juandrodriguezf/robot-dibujante-2gdl/docs/informe-1/main.tex

\documentclass[10pt, letterpaper]{article}

\usepackage[utf8]{inputenc}
\usepackage[spanish]{babel}
\usepackage{amsmath}
\usepackage{amsfonts}
\usepackage{amssymb}
\usepackage{graphicx}
\usepackage{epstopdf}
\usepackage{url}
\usepackage{booktabs}
\usepackage{caption}
\usepackage{float}
\usepackage{tikz}
\usepackage{subcaption}
\usetikzlibrary{calc}
\usepackage{titlesec}
\usepackage[left=2.2cm, right=2.2cm, top=2.0cm, bottom=2.0cm]{geometry}

\titlespacing*{\section}{0pt}{8pt}{3pt}
\titlespacing*{\subsection}{0pt}{6pt}{2pt}
\setlength{\parskip}{0pt}
\captionsetup{font=small, skip=3pt}

% Estilos del diagrama de bloques
\tikzset{
  bloque/.style={draw, rectangle, align=center, font=\scriptsize,
                 minimum height=0.80cm, inner sep=3pt},
  suma/.style={draw, circle, minimum size=0.58cm, inner sep=0pt,
               font=\footnotesize},
  senal/.style={->, thick, >=latex},
  etiqueta/.style={font=\scriptsize, inner sep=1.5pt}
}

\begin{document}
\begin{center}
    {\LARGE Proyecto --- Parte 1: Especificaciones y modelado cinemático de robot de 2 GdL}
\end{center}
\textbf{Estudiantes: } 
\begin{enumerate}
    \item José Elkin Estrada Morales - \url{estradam_jose@javeriana.edu.co}
    \item Juan David Rodríguez Franco  - \url{juandrodriguezf@javeriana.edu.co}
    \item David Santiago Mojica Lugo -
    \url{david-mojical@javeriana.edu.co}
\end{enumerate}

\section{Métodos y Desarrollos}

\subsection{Introducción y objetivo del proyecto}

El presente proyecto tiene como objetivo diseñar y fabricar un robot manipulador de 2 grados de libertad (GdL) junto a la electrónica necesaria y la implementación de un sistema de control de movimiento. El propósito del robot será trazar una figura de manera autónoma sobre una superficie (como papel; véase la figura \ref{fig:draw_manipu} como referencia). La forma seleccionada por el equipo de trabajo será un triángulo con vértices redondeados (como se muestra en la figura \ref{fig:reul_triag}), conocido matemática y formalmente como ``triángulo de Reuleaux". 

\begin{figure}[H]
    \centering
    % Primera figura (a)
    \begin{subfigure}[b]{0.25\textwidth}
        \centering
         % Reemplaza por tu primera imagen
        \caption{\textit{Drawing manipulator} de Quanser \cite{barbosa_quanser}.}
        \label{fig:draw_manipu}
    \end{subfigure}
    \hspace{1cm}% Crea un espacio horizontal automático entre ambas figuras
    % Segunda figura (b)
    \begin{subfigure}[b]{0.25\textwidth}
        \centering
         % Reemplaza por tu segunda imagen
        \caption{Triaángulo de Reuleaux}
        \label{fig:reul_triag}
    \end{subfigure}
    
    % Caption y Label general de todo el conjunto
    \caption{\textbf{Izquierda:} Tipo de robot a diseñar. \textbf{Derecha: }Figura geométrica a realizar.}
    \label{fig:conjunto_figuras}
\end{figure}

La tarea concreta del robot será seguir una trayectoria continua con la geometría del triángulo. Para cumplir con dicho objetivo, el sistema debe, de forma iterativa y por cada punto de la trayectoria mencionada, establecer un modelo de cinemática directa de la posición actual y, justo después, resolver la cinemática inversa de la siguiente \cite{nakamura}, convirtiendo sus coordenadas en el espacio cartesiano en los valores requeridos de las variables articulares para que el efector final alcance dicho punto. La figura \ref{fig:block_diagram} muestra un diagrama de bloques que ilustra el proceso anteriormente mencionado. 

\begin{figure}[H]
    \centering
    
    \caption{Diagrama de bloques del funcionamiento del sistema}
    \label{fig:block_diagram}
\end{figure}

\subsection{Requerimientos}

Los requerimientos del robot dependen de aspectos como complejidad de las trayectorias, carga a soportar (en este caso un marcador), el volumen de trabajo y la dexteridad requerida. A continuación se presentan definiciones y más detalles sobre estos aspectos:

\textbf{Complejidad de la trayectoria:} La complejidad de una trayectoria puede cuantificarse a través de las siguientes métricas \cite{spong}: 

\begin{itemize}
    \item \textbf{Continuidad matemática ($C^k$): } En robótica, la continuidad matemática puede entenderse como la propiedad de que los movimientos de un robot no presenten cambios bruscos durante su ejecución \cite{spong}. Por ejemplo, una trayectoria puede clasificarse como $C^0$ si es continua (por ejemplo, que no sea necesario levantar el lápiz del papel para dibujar una figura), como $C^1$ es continua y así sucesivamente. 
    
    \item \textbf{Geometría del perfil y su curvatura: } La curvatura $\kappa$ es una medida de qué tan ``cerrado'' o pronunciado es un cambio de dirección en un punto específico de la trayectoria \cite{spong}. Matemáticamente, puede definirse como $ \kappa = |\dot{x}\ddot{y} - \dot{y}\ddot{x}|/(\dot{x}^2 + \dot{y})^{3/2}$, donde $x(t)$ y $y(t)$ son las coordenadas del marcador en el plano de dibujo a través del tiempo \cite{spong}. 

    \item \textbf{Frecuencia de muestreo y resolución de puntos: } Al seguir una trayectoria, el microcontrolador une cada uno de los puntos moviendo en línea recta el efector final. Si la frecuencia de muestreo es baja o no hay suficientes puntos en la trayectoria, las curvas no estarán bien logradas y la forma final será diferente a la esperada.
\end{itemize}
\textbf{Carga a soportar: } Los marcadores suelen tener una masa aproximadamente de 30 g, lo que implica un peso de 0.294 N. No es una carga significativa.

\textbf{Volumen de trabajo: } Es el conjunto de todos los puntos en el espacio tridimensional o bidimensional $(x, y)$ que el efector final del robot puede alcanzar \cite{spong}. Para un robot de 2 GdL plano, el volumen de trabajo es una región plana 2D con la forma de una semicorona circular con radio interior $R_{min} = L_1 - L_2$ y radio exterior $R_{max} = L_1 + L_2$. Como se verá en la sección \ref{sec:disenio}, se seleccionó $L_1 = 20 \text{ cm}$ y $L_2 = 10 \text{ cm}$. En ese orden de ideas, la región plana 2D del volumen de trabajo corresponde a una semicorona circular, mientras que la región 3D por la que el efector final puede desplazarse se muestra en la figura \ref{fig:3d_workspace}.

\begin{figure}[H]
    \centering
    
    \caption{Volumen de trabajo 3D del robot manipulador}
    \label{fig:3d_workspace}
\end{figure}

\textbf{Dexteridad: } Es la capacidad cinemática del manipulador para cambiar libremente la posición y orientación de de su efector final en un punto específico del espacio de trabajo \cite{spong}. Se cuantifica matemáticamente a partir de la matriz jacobiana $J(q)$ y métricas como el \textbf{Índice de Manipulabilidad de Yoshikawa}, definido como $w(q) = \sqrt{\det(J(q)J^T(q))}$ \cite{spong}. Para robots planares de 2 GdL, $w(q)$ puede escribirse como $w(q) = \vert L_1L_2\sin(\theta_2) \vert$ \cite{spong}, donde $\theta_2$ es el ángulo asociado a la segunda articulación. $w(q)$ mide qué tan ``lejos'' está el robot de una configuración singular. 

Por otra parte, otra métrica es el \textbf{Número de Condición del Jacobiano} \cite{spong}, expresado como
 
\begin{equation*}
   \kappa(J) = \Vert J \Vert \cdot \Vert J^{-1} \Vert = \frac{\sigma_{max}}{\sigma_{min}},
\end{equation*}

donde $\sigma_{max}$ y $\sigma_{min}$ son, respectivamente, los valores singulares máximos y mínimos de $J$. 

Teniendo en cuenta todos los aspectos mencionados anteriormente, los requerimientos establecidos para el sistema se muestran en la tabla \ref{tab:requerimientos}.

\begin{table}[H]
    \centering
    \caption{Requerimientos del sistema}
    \label{tab:requerimientos}
    \begin{tabular}{|p{4.5cm}|p{4.5cm}|p{6cm}|}
    \hline
    \textbf{Especificación} & \textbf{Métrica} & \textbf{Breve justificación} \\ \hline
    Continuidad matemática & $C^1$ (posición y velocidad continuas) & Garantiza transiciones suaves de movimiento \\ \hline
    Velocidad cartesiana en los vértices & $v \to 0$ (tendiendo a cero) & Prevenir discontinuides en la función de curvatura $\kappa$. \\ \hline
    Tiempo de muestreo & $\Delta t \le 0.01$ s ($f_s \ge 100$ Hz) & Garantizar un seguimiento fino y evitar la poligonalización del trazado curvo. \\ \hline
    Orden polinómico de interpolación & Polinomios de orden 3 (splines cúbicos) & Asegura la continuidad $C^1$, proporcionando perfiles de velocidad continuos. \\ \hline
    Capacidad de carga útil (Payload) & $\ge 0.294$ N ($30$ g) & Garantizar el soporte del marcador sin afectar la dinámica. \\ \hline
    Alcance radial de la zona de trabajo & Semicorona circular con $R_{min} = 10$ cm y $R_{max} = 30$ cm & Contener al triángulo de Reuleaux, alejándolo de los límites físicos y configuraciones singulares del brazo. \\ \hline
    Límite del Índice de Yoshikawa & Evitar $\theta_2 = 0^\circ$ y $\theta_2 = 180^\circ$ & Evitar la pérdida de grados de libertad por efecto de singularidades. \\ \hline
    Número de Condición del Jacobiano & $\kappa(J)$ cercano a $1$ ($\kappa(J) \ll \infty$) & Evitar configuraciones singulares (de forma parecida al índice de Yoshikawa) \\ \hline
    \end{tabular}
\end{table}
 
\subsection{Componentes}

Los componentes necesarios para el robot se muestran en la tabla \ref{tab:compos}.

\begin{table}[H]
    \centering
    \caption{Componentes del sistema con características, función y costos asociados}
    \label{tab:compos}
    \begin{minipage}{15.2cm} % Ajustado a la suma de las columnas: 3.2 + 4.5 + 4.5 + 2.2 = 14.4cm + márgenes
        \centering
        \begin{tabular}{|p{3.2cm}|p{4.5cm}|p{4.5cm}|p{2.2cm}|}
        \hline
        \textbf{Componente} & \textbf{Características} & \textbf{Función} & \textbf{Costo (COP)} \\ \hline
        Servomotores Futaba S3003 (x2) & \textbf{Torque:} 4.1 kg-cm \newline \textbf{Voltaje:} 6 V \newline \textbf{Rotación:} 180$^\circ$ \newline \textbf{Velocidad*:} 0.19 s / 60$^\circ$ & Actuadores & \$37 800 \\ \hline
        Microcontrolador ESP32-S3 & Procesador Xtensa® LX7 de doble núcleo \newline 16 MB de memoria Flash \newline 8 MB de memoria PSRAM & Solución de problemas cinemáticos, control de movimiento e interpolación de trayectorias. & Posesión del equipo \\ \hline
        Lámina de balso & Tamaño & Material para base y eslabones. & \$20 000 \\ \hline
        Marcador Sharpie & Color negro & Dibujo & \$2 500 \\ \hline
        \end{tabular}
        
        \vspace{1.5mm} % Controla la cercanía del texto con la tabla
        \raggedright \footnotesize $^*$ Como puede intuirse, las velocidades máximas articulares del robot coinciden con las velocidad de los servomotores.
    \end{minipage}
\end{table}
\section{Dise\~no y par\'ametros DH}
\label{sec:disenio}
El robot tiene una base fija y dos eslabones de balso, cada uno movido por un servo; el esfero va en el extremo del eslab\'on~2. Los dos ejes son verticales y paralelos, por lo que la punta se mueve en el plano del papel.
 
\textbf{Marcos y par\'ametros DH.} Se us\'o la convenci\'on DH est\'andar (Fig.~\ref{fig:marcos}). El marco mundo $\{W\}$ est\'a sobre el papel y $\{0\}$ queda sobre el eje del servo~1 a $h_0=48{,}5$~mm de altura: ${}^{W}\mathbf{T}_{0}=\mathrm{trasl}(0,0,h_0)$. Los ejes $z_0$ y $z_1$ son verticales, as\'i que $\alpha_1=\alpha_2=0$ y las articulaciones son rotacionales ($\sigma_i=0$). Los dem\'as par\'ametros salen de la geometr\'ia (Tabla~\ref{tab:dh}):
$a_1=200$~mm y $a_2=100$~mm son las distancias entre ejes; $d_1=20$~mm es la altura de $\{0\}$ a $\{1\}$ (plano del eslab\'on~2), por lo que $\{1\}$ queda a $h_0+d_1=68{,}5$~mm del papel; y $d_2=-68{,}5$~mm baja de $\{1\}$ hasta $\{2\}$, ubicado en la punta del esfero sobre el papel ($z_W=0$).
 
\begin{table}[!t]
\caption{Par\'ametros DH (est\'andar), $q_i\in[-90^\circ,90^\circ]$}
\label{tab:dh}
\centering
\begin{tabular}{c c c c c c}
\toprule
$i$ & $\theta_i$ & $d_i$ [m] & $a_i$ [m] & $\alpha_i$ [rad] & $\sigma_i$ \\
\midrule
1 & $q_1$ & $+0{,}0200$ & $0{,}2000$ & 0 & 0 \\
2 & $q_2$ & $-0{,}0685$ & $0{,}1000$ & 0 & 0 \\
\bottomrule
\end{tabular}
\end{table}
 
\begin{figure}[!t]
\centering
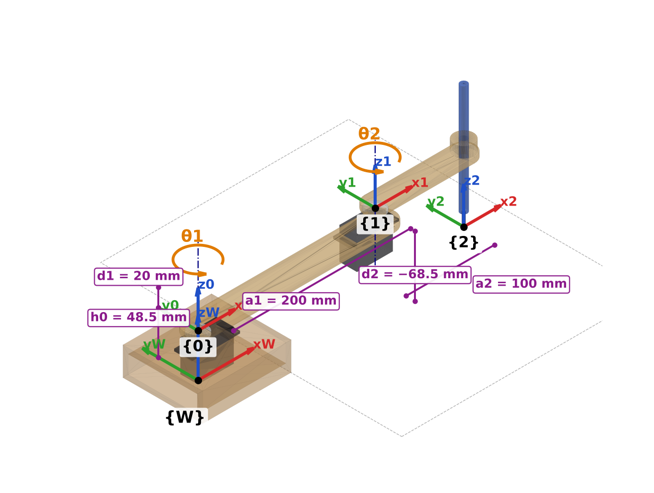
[picture p2: docs/informe-1/figuras/esquematico_1.png]
\hfill
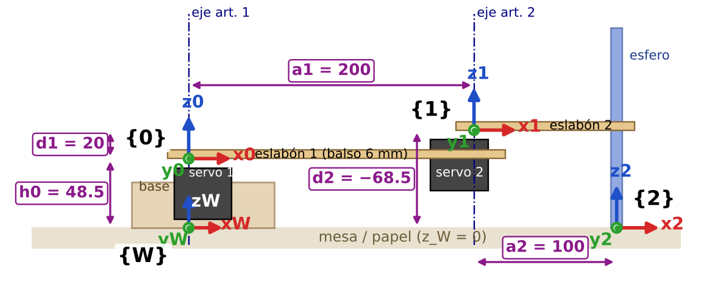
[picture p3: docs/informe-1/figuras/esquematico_2.png]

\caption{Marcos $\{W\}$, $\{0\}$, $\{1\}$, $\{2\}$ y dimensiones del robot.}
\label{fig:marcos}
\end{figure}
 
Con estos valores, las matrices de transformaci\'on son
\begin{equation}
{}^{0}\mathbf{A}_{1}\!=\!\begin{bmatrix}c_1&-s_1&0&0{,}2c_1\\ s_1&c_1&0&0{,}2s_1\\ 0&0&1&0{,}02\\ 0&0&0&1\end{bmatrix}\!,\;
{}^{1}\mathbf{A}_{2}\!=\!\begin{bmatrix}c_2&-s_2&0&0{,}1c_2\\ s_2&c_2&0&0{,}1s_2\\ 0&0&1&-0{,}0685\\ 0&0&0&1\end{bmatrix}
\end{equation}
y ${}^{W}\mathbf{T}_{2}={}^{W}\mathbf{T}_{0}\,{}^{0}\mathbf{A}_{1}\,{}^{1}\mathbf{A}_{2}$. La altura de la punta es $0{,}0485+0{,}02-0{,}0685=0$ y su posici\'on en el plano es $x=0{,}2\cos q_1+0{,}1\cos(q_1+q_2)$, $y=0{,}2\sin q_1+0{,}1\sin(q_1+q_2)$. En \textit{home} la punta queda en $(0{,}3;\,0;\,0)$~m.
 
\textbf{Masas e inercias.} Se obtuvieron en SolidWorks (propiedades de masa) agrupando las piezas por cuerpo r\'igido: la base lleva el servo~1 y el eslab\'on~1 lleva el servo~2, que viaja con \'el; el eslab\'on~2 incluye el balso, el \textit{horn} y el esfero. Los valores est\'an referidos al centro de masa y expresados en los ejes del marco $\{i\}$ de cada eslab\'on. Las masas son $m_1=43{,}90$~g y $m_2=10{,}34$~g (54,24~g en movimiento), con centros de masa
$\mathbf{r}_1=[-0{,}02689;\,0;\,-0{,}02310]$~m y $\mathbf{r}_2=[-0{,}02227;\,0;\,0{,}07451]$~m, y tensores de inercia (kg\,m$^2$)
{\footnotesize
\begin{equation}
\mathbf{I}_1\!=\!\begin{bmatrix}6{,}0512\mathrm{e}{-6}&0&3{,}7272\mathrm{e}{-6}\\ 0&1{,}0736\mathrm{e}{-4}&0\\ 3{,}7272\mathrm{e}{-6}&0&1{,}0469\mathrm{e}{-4}\end{bmatrix}
\end{equation}
\begin{equation}
\mathbf{I}_2\!=\!\begin{bmatrix}8{,}5081\mathrm{e}{-6}&0&-1{,}0612\mathrm{e}{-6}\\ 0&2{,}2523\mathrm{e}{-5}&0\\ -1{,}0612\mathrm{e}{-6}&0&1{,}4440\mathrm{e}{-5}\end{bmatrix}
\end{equation}
}
Como los ejes son verticales, en el plano solo intervienen $I_{zz}$ y la posici\'on de los centros de masa.
 
\textbf{Validaci\'on.} El modelo se implement\'o con \texttt{SerialLink} cargando la Tabla~\ref{tab:dh} y los valores anteriores, y se verific\'o que: (i) \texttt{fkine([0 0])} da $(0{,}3;0;0)$~m, igual al CAD; (ii) con 2000 poses aleatorias, \texttt{fkine} coincide con las matrices DH a mano y con la geometr\'ia anal\'itica (error $<10^{-12}$); (iii) la matriz de inercia $\mathbf{M}(\mathbf{q})$ de la toolbox coincide con un c\'alculo independiente por Steiner (error $<10^{-10}$); (iv) la masa en movimiento coincide con SolidWorks; y (v) \texttt{gravload}$\,\approx 0$, pues la estructura soporta el peso y los servos solo vencen la inercia.
 
%-----------------------------------------------------------------------
\section{Modelo CAD}
El modelo se realiz\'o en SolidWorks como ensamblaje (\texttt{Plotter\_2GdL.SLDASM}) con base, dos eslabones de balso de 6~mm, dos servos S3003, \textit{horn} y esfero (Fig.~\ref{fig:cad}). De \'el se extrajeron las longitudes, los desplazamientos $d_i$, las masas y las inercias usadas arriba.
 
\begin{figure}[!t]
\centering
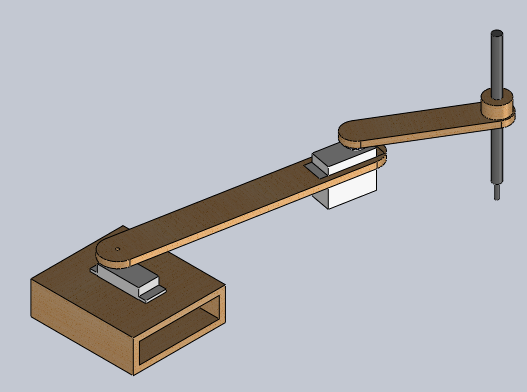
[picture p4: docs/informe-1/figuras/cad_isometrica.png]
\hfill
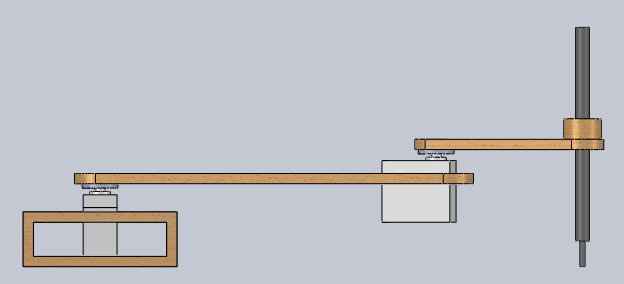
[picture p5: docs/informe-1/figuras/cad_lateral.png]

\caption{Modelo CAD del plotter: vista isom\'etrica (izq.) y lateral (der.).}
\label{fig:cad}
\end{figure}

\section{Resultados}

\subsection{Cinemática directa}

La cinemática directa se implementó en \texttt{forward\_kinematics(DH,q)} sobre
los marcos de la figura~\ref{fig:marcos} y se validó en $q=[60^\circ,-50^\circ]$:
coincide con la solución analítica y con \texttt{SerialLink.fkine} del Robotics
Toolbox con un error máximo de $2{,}8\times10^{-17}$~m. El volumen de trabajo es
una corona con $R_{min}=L_1-L_2=0{,}1$~m y $R_{max}=L_1+L_2=0{,}3$~m que
contiene al triángulo de Reuleaux.

\subsection{Cinemática inversa}

Para el brazo plano $\dot{\mathbf p}_e=\mathbf J_v(q)\,\dot{\mathbf q}$, con
$\mathbf J_v$ el Jacobiano lineal y $\det\mathbf J_v=L_1L_2\sin q_2$ (singular
en $q_2=0^\circ$ o $180^\circ$). La inversa itera
$\mathbf q_{k+1}=\mathbf q_k+\mathbf J_v^{+}\bigl(\mathbf p_{obj}-\mathbf p_e(\mathbf q_k)\bigr)$
(pseudoinversa de Moore--Penrose, amortiguada cerca de singularidades). El
Jacobiano se verificó en $q=[30^\circ,-70^\circ]$, donde
$\det\mathbf J_v=-0{,}018794=L_1L_2\sin q_2$. Para
$\mathbf p_{obj}=[0{,}08;\,0{,}20]$~m la forma cerrada da las ramas
A $q=[40{,}7^\circ,\,95{,}2^\circ]$ y B $q=[95{,}7^\circ,\,-95{,}2^\circ]$;
\texttt{ikine} recupera \emph{ambas} según la semilla con error de posición
$<3\times10^{-11}$~m (figura~\ref{fig:ik_ramas}). El índice de manipulabilidad
$w=L_1L_2|\sin q_2|$ es máximo en $r=\sqrt{L_1^2+L_2^2}=0{,}2236$~m y tiende a
cero en los límites $r=0{,}1$ y $0{,}3$~m (figura~\ref{fig:ik_sing}).

\begin{figure}[!t]
\centering
\begin{subfigure}[b]{0.38\columnwidth}
    \centering
    
    \caption{Ramas A y B (codo arriba/abajo) al mismo punto.}
    \label{fig:ik_ramas}
\end{subfigure}\hfill
\begin{subfigure}[b]{0.38\columnwidth}
    \centering
    
    \caption{Manipulabilidad $|\det\mathbf J_v|$ vs.\ radio $r$.}
    \label{fig:ik_sing}
\end{subfigure}
\caption{Resultados de la cinemática inversa.}
\end{figure}

\subsection{Planeación de trayectorias}

Se trazó el triángulo de Reuleaux ($w=0{,}10$~m, centro $(0;\,0{,}20)$~m),
discretizado en $50$ puntos e interpolado con splines cúbicos; un reescalado
temporal suave anula la velocidad cartesiana en los tres vértices. Con muestreo
$\Delta t=0{,}01$~s ($2001$ puntos) la inversa convergió en todos los puntos con
error $<1\times10^{-10}$~m. Las figuras~\ref{fig:tray_cart} y
\ref{fig:tray_art} muestran las trayectorias cartesiana y articular; las
velocidades máximas ($0{,}15$ y $0{,}21$~rad/s) quedan por debajo del límite de
los servos S3003 ($5{,}5$~rad/s). La figura~\ref{fig:tray_cad} presenta la
simulación con el modelo CAD real.

\begin{figure}[!t]
\centering
\begin{subfigure}[b]{0.38\columnwidth}
    \centering
    
    \caption{Trayectoria cartesiana $x(t)$, $y(t)$ y trazado.}
    \label{fig:tray_cart}
\end{subfigure}\hfill
\begin{subfigure}[b]{0.38\columnwidth}
    \centering
    
    \caption{Trayectorias articulares $q(t)$, $\dot q(t)$, $\ddot q(t)$.}
    \label{fig:tray_art}
\end{subfigure}
\caption{Resultados de la planeación de trayectorias.}
\end{figure}

\begin{figure}[!t]
\centering

\caption{Simulación con el modelo CAD real ejecutando el trazado.}
\label{fig:tray_cad}
\end{figure}

\section{Conclusiones}

El modelo cinemático quedó validado: la cinemática directa coincide con la
analítica y con el Robotics Toolbox (error $\sim10^{-17}$~m), y la inversa por el
Jacobiano recupera ambas configuraciones con error $<10^{-10}$~m, lejos de las
singularidades ($q_2 = 0^\circ,\,180^\circ$).

La planeación genera perfiles articulares $C^1$ con velocidad nula en los
vértices y convergencia en los $2001$ puntos; las velocidades máximas
($0{,}15$ y $0{,}21$~rad/s) quedan bajo el límite del servo ($5{,}5$~rad/s).

\bibliographystyle{ieeetr} % Define el estilo de formato (puedes cambiarlo por plain, unsrt, etc.)
\bibliography{referencias} % Llama a tu archivo .bib (no incluyas la extensión .bib aquí)

\end{document}
