juandrodriguezf/robot-dibujante-2gdl/docs/informe-2/main.pdf

# Proyecto — Parte 2: Dinámica inversa, modelado y control de un drawing manipulator de 2 GdL

Estudiantes:

1. José Elkin Estrada Morales - estradam_jose@javeriana.edu.co
2. Juan David Rodríguez Franco - juandrodriguezf@javeriana.edu.co
3. David Santiago Mojica Lugo - david-mojical@javeriana.edu.co

## 1. Métodos y Desarrollos

### 1.1. Modelo de dinámica inversa

Tras haber resuelto los modelos de cinemática directa, inversa y las trayectorias, la descripción geométrica del movimiento del manipulador queda completamente definida. En la presente entrega se aborda el modelo de dinámica inversa. Este proceso consiste en determinar los torques y fuerzas que deben ejercer los actuadores para que el efector final alcance y siga las posiciones, velocidades y aceleraciones deseadas a lo largo del recorrido, para posteriormente seleccionar los motores adecuados para las cargas del sistema. El flujo de variables que describen este procedimiento se ilustran en el diagrama de bloques de la figura 1.

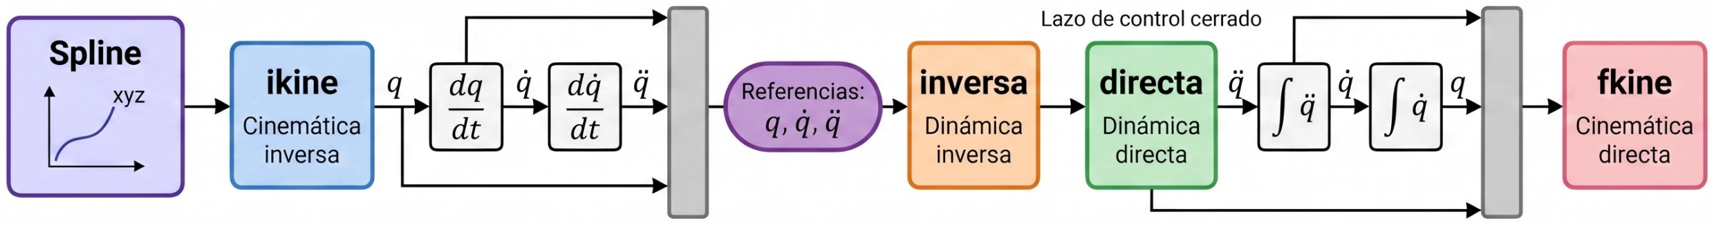
[picture p6: figure]

Figura 1: Diagrama de bloques de algoritmo completo para control de un manipulador

Así, para resolver el modelo dinámico inverso del manipulador se implementó el algoritmo recursivo de Newton-Euler (RNE, por sus siglas en inglés). Este método es la línea base del estado del arte debido a su alta eficiencia computacional y a su escalabilidad a robots con más GdL. El algoritmo determina iterativamente las velocidades, aceleraciones y fuerzas propagadas en cada eslabón a partir de tres ecuaciones principales para cada variable, las cuales se muestran en (1)

Vi = RT P Vi−1 + Hq˙i
V˙

i = RT PV˙

i−1 + W˜

i−1RT P Vi−1 + Hiqï + W˜
iHq˙i
Fi = P

T RFi+1 + IiV˙

i + [IiW˜

iSi,cm + W˜
iIi

] · Vi

. | (1)

Donde, para cada eslabón i, Vi y V˙ i representan los vectores de velocidad y aceleración espacial en R

6
(que
agrupan las componentes angulares y lineales), mientras que ˙qi y ¨qi corresponden a la velocidad y aceleración escalar de la articulación. Por su parte, R y P denotan los operadores espaciales de rotación y traslación entre sistemas de referencia consecutivos, y H (o Hi) es el vector de proyección espacial que refleja el movimiento sobre el eje de actuación correspondiente. Asimismo, W˜
i ∈ R

6×6
es una matriz diagonal por bloques conformada por las matrices antisimétricas de las velocidades angulares del eslabón. Finalmente, Fi representa el vector de fuerza espacial (torsor de fuerzas y momentos) ejercido en la articulación, Ii corresponde al operador espacial de inercia del cuerpo rígido y Si,cm es el operador espacial de traslación desde el marco de referencia de la articulación hasta el centro de masa del eslabón.
En este orden de ideas, el procedimiento recursivo finaliza extrayendo el torque o fuerza escalar (τi) requerido por cada articulación para ejecutar el movimiento deseado. Dicha magnitud se obtiene proyectando el vector de fuerza espacial Fi ∈ R

6×1
sobre el vector transpuesto del subespacio de movimiento articular HT

i ∈ R 1×6
, tal
como se expresa en (2).

τi = HT
i Fi | (2)

Esta operación aísla la componente de esfuerzo efectiva sobre el eje de actuación —correspondiente al momento τz en articulaciones rotacionales o a la fuerza fz en prismáticas—, proporcionando los valores críticos de carga necesarios para dimensionar y validar la selección de los actuadores del manipulador.

### 1.2. Modelado de motores y sensores

El S3003 es un servo integrado: incluye motor, reductora, potenciómetro y controlador analógico. El lazo de posición ya viene cerrado y el servo solo recibe PWM; por eso, para simulación se adopta un motor DC equivalente de primer orden referido al eje de salida, calibrado con el datasheet [1]. En la parte experimental se usa el S3003 tal como se compró.
El modelo se implementó en MATLAB/Simulink con una instancia por grado de libertad: Joint1 y Joint2 en motor 2gdl.slx. Cada instancia incluye la planta DC y los sensores de posición, corriente y velocidad necesarios para el control de bajo nivel de su articulación. La figura 2 presenta el diagrama de una instancia (Joint1); el modelo completo contiene dos instancias idénticas, Joint1 y Joint2, una por grado de libertad. Los parámetros se ajustaron con el datasheet del S3003. No se usó Simscape Electrical porque no está licenciado; se emplearon

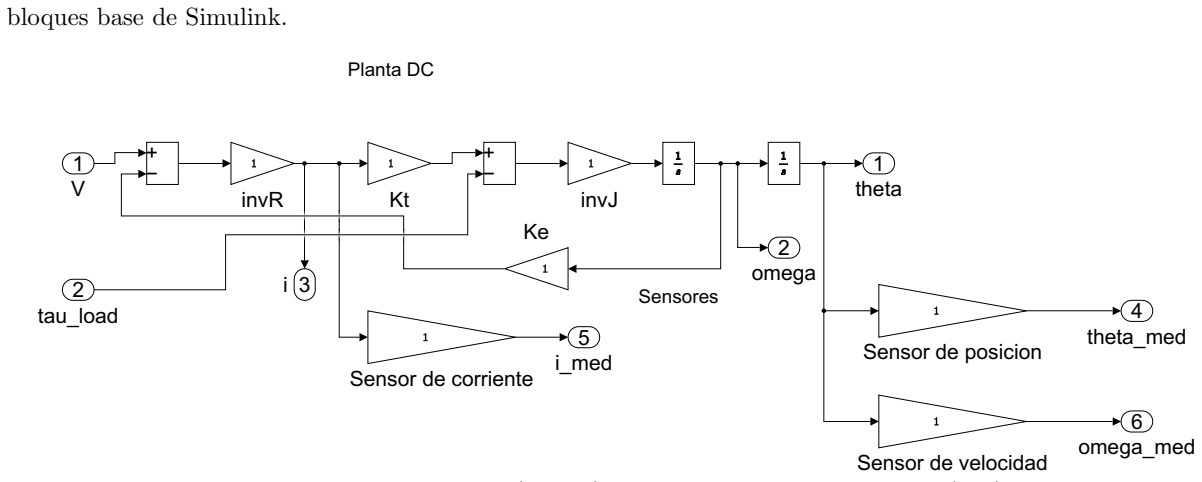
[picture p7: figure]
bloques base de Simulink.; Sensores; Planta DC; 2 tau_load; invR; invJ; 1 theta; 2 omega; Sensor de posicion; 4 theta_med; Sensor de corriente; 5 i_med; Sensor de velocidad; 6 omega_med

Figura 2: Diagrama de bloques de una instancia (Joint1) del modelo de motor y sensores (P10). El modelo completo contiene dos instancias idénticas, una por GdL.

El modelo resuelve las ecuaciones

i =

V − Keω
R
, | (3)
Jω˙ = Kti − τload, | (4)
˙θ = ω, | (5)

donde V es la tensión de entrada, i la corriente, ω la velocidad y θ la posición del eje de salida. La corriente se obtiene con (3), la dinámica mecánica con (4) y la posición integrando (5). La inductancia L y el amortiguamiento B se desprecian para obtener el modelo de primer orden; J se estima a partir de un valor típico de servo pequeño. Los parámetros se resumen en la tabla 1.

Tabla 1: Parámetros del motor equivalente.

Parámetro | Notación | Valor [Unidad]
Constante de fuerza y par | Ke = Kt | 1,0886 V·s/rad = N·m/A
Resistencia | R | 16,245 Ω
Inercia | J | 3 × 10⁻⁴ kg·m²
Inductancia | L | 0 H
Amortiguamiento | B | 0 N·m·s/rad
Tensión máxima | Vmax | 6 V
Velocidad sin carga | ωnl | 5,5116 rad/s
Par de bloqueo | τstall | 0,4021 N·m
Corriente de bloqueo | istall | 0,3693 A
Constante de velocidad | K = 1/Ke | 0,9186 rad/s/V
Constante de tiempo | τm = JR/(KtKe) | 4,11 ms

Los valores de Ke, R, Vmax, ωnl y τstall provienen del datasheet; J es estimada y L, B se desprecian.

Los sensores se modelan de forma genérica, porque el S3003 no expone el potenciómetro ni la corriente del motor. La tabla 2 resume sus características.

Tabla 2: Sensores modelados para el control de bajo nivel de cada GdL.

Sensor | Modelo | Parámetros
Posición | Cuantización + ruido + saturación | ±90◦
; 0,5

◦

; 0,05◦
Corriente | Filtro + ruido + saturación | ±1 A; 2 mA; 1000 Hz
Velocidad | Derivada filtrada | 20 Hz

El periodo de muestreo es Ts = 0,01 s. La carga mecánica se incluye como series de tiempo tau1 y tau2, calculadas con carga mecanica.m; el par máximo es 0,177 mN·m y su efecto en la velocidad es 0,0013 rad/s (0,024 %).

### 1.3. Control de bajo nivel

El S3003 ya incorpora un lazo interno de posición. Para simular el control de bajo nivel se replicó un controlador proporcional con prealimentación de velocidad en cada instancia (Joint1 y Joint2). La ley implementada en (6), evaluada con Ts = 10 ms y la posición medida, es

Vk = sat±6

h
Kp

θref,k − θmed,k

+ Kf f ˙θref,ki
, | (6)

con Kp = 40/K = 43,5 V/rad y Kf f = Ke = 1,0886 V·s/rad. El término Kf f ˙θref entrega la tensión asociada a la fuerza contraelectromotriz, de modo que el término proporcional solo corrige el error de posición. Si se desprecia la carga y la saturación no actúa, al sustituir la ley de control en la planta de P10 el error e = θref − θ obedece a (7):

Jë+

KtKe
R

e˙ +

KtKp
R

e = 0, ωn =

r
KtKp
JR

, ζ =

KtKe/R
2Jωn
. | (7)

Con J = 3 × 10⁻⁴ kg·m²
, R = 16,245 Ω, Kt = Ke = 1,0886 y Kp = 43,5 V/rad se obtiene ωn = 98,6 rad/s y ζ = 1,23; el lazo es estable y sobreamortiguado, por lo que el escalón no presenta oscilación apreciable.
No se incluyó acción integral porque la cuantización de 0,5
- produciría ciclos límite. La realimentación utiliza solo la posición medida; no se realimenta la velocidad, evitando amplificar el ruido de la derivada. El controlador se replica dentro de cada instancia Joint1 y Joint2 de motor 2gdl ctrl.slx, evaluado cada Ts = 10 ms con retenedor de orden cero. Para evitar la saturación de ±90◦ del sensor, cada servo se monta con un desfase qof f = [60◦

, 95◦
], de modo que θservo = q − qof f .

## 2. Resultados

### 2.1. Validación de modelo del motor

La tabla 3 resume la verificación del modelo contra el datasheet.

Tabla 3: Verificación del modelo.

Prueba | Esperado | Obtenido
ωnl a 6 V | 5,5116 rad/s | 5,5116 rad/s
ωnl a 3 V | 2,7558 rad/s | 2,7558 rad/s
τm | 4,11 ms | 4,3 ms
istall | 0,3693 A | 0,3693 A
τstall | 0,4021 N·m | 0,4021 N·m
∆ω con carga mecánica | 0 | 0,0013 rad/s

El modelo reproduce la velocidad sin carga y el par de bloqueo; la carga mecánica es despreciable. La posición medida tiene un error máximo de 0,28◦ y la corriente un error máximo de 0,271 A en el escalón (RMS 0,0168 A). La velocidad derivada es ruidosa (RMS 0,754 rad/s). Las figuras 3a y 3b muestran las respuestas y los sensores.

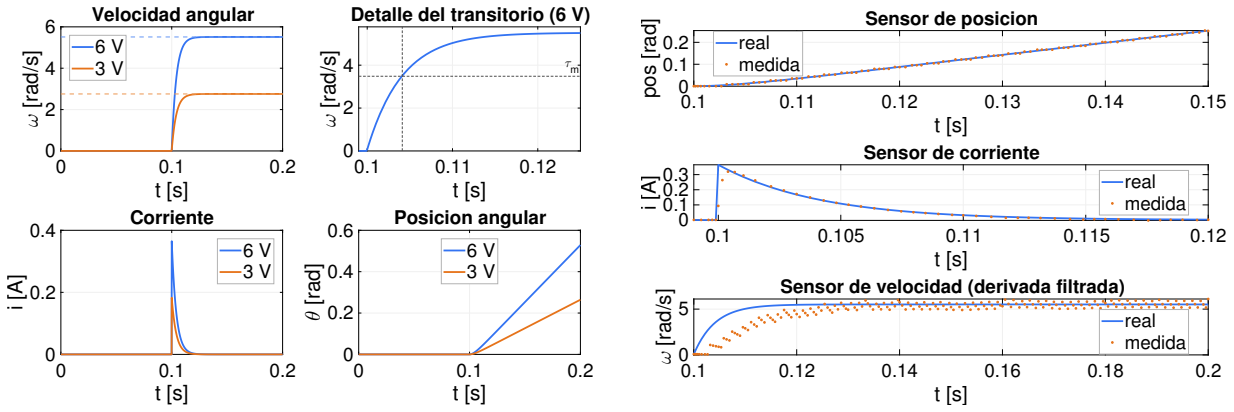
[picture p8: figure]
ω [rad/s]; Velocidad angular; Detalle del transitorio (6 V); Corriente; θ [rad]; Posicion angular; pos [rad] 0; Sensor de posicion; real medida; Sensor de corriente; 0.2 ω [rad/s] 0; Sensor de velocidad (derivada filtrada)

(a) Respuesta a escalones de 6 V y 3 V.
(b) Señales reales y medidas de los sensores. Figura 3: Respuesta del modelo y señales de los sensores de posición, corriente y velocidad.

### 2.2. Resultados de dinámica inversa

Después de la implementación y la ejecución de RNE en MATLAB pudieron hallarse los valores de torque máximos necesarios, los cuales se muestran en la Tabla 4. El algoritmo se validó contra la función rne del Robotics Toolbox en 200 poses aleatorias, con un error máximo de 0 N·m.

Tabla 4: Torques máximos requeridos por articulación mediante RNE
Articulación | Máx. Absoluto (N · m) | Pico Positivo (N · m) | Pico Negativo (N · m)
1 | 1,7743 × 10⁻⁴
(pto. 600) | 1,7743 × 10⁻⁴
(pto. 600) | −1,6375 × 10⁻⁴
(pto. 1271)
2 | 3,1963 × 10⁻⁵
(pto. 1934) | 1,7928 × 10⁻⁵
(pto. 1897) | −3,1963 × 10⁻⁵
(pto. 1934)

Para esta trayectoria, las velocidades articulares máximas son 0,150 y 0,206 rad/s y las aceleraciones máximas 0,102 y 0,413 rad/s²
en las articulaciones 1 y 2, respectivamente. Estos valores, junto con la fuerza normal del marcador, son la entrada del algoritmo RNE.
La reducida magnitud de los torques obtenidos se justifica por dos factores físicos propios del diseño del sistema. En primer lugar, dado que el manipulador opera en un plano horizontal (XY ) y sus articulaciones rotan alrededor del eje Z, el momento generado por la gravedad (τ g = r×mg) actúa exclusivamente sobre los ejes X e Y , anulando cualquier carga gravitacional estática sobre los motores (τz = 0). En segundo lugar, debido a la baja masa de los eslabones de balso (L1 = 20 cm, L2 = 10 cm) y del marcador (30 g), los momentos de inercia del conjunto son del orden de 10⁻⁴ kg · m²
. En consecuencia, los actuadores únicamente deben vencer los esfuerzos puramente inerciales y de Coriolis (τ = Iq¨+ Cq˙) asociados a una trayectoria suave, lo que explica que los pares requeridos se mantengan en el orden de magnitud obtenido.
La anterior información nos permite seleccionar motores apropiados para la aplicación actual. Algunas opciones comerciales de motores prometedores para este caso se muestran en la Tabla 5.

Tabla 5: Comparativa de opciones comerciales de motores para los actuadores del robot.
Criterio | Servomotor (Futa-
ba S3003) [1]

Motor Paso a Paso
(28BYJ-48) [2]

Motor DC (Genéri-co con reductora)
Costo estimado | Medio ($18 900 COP) | Bajo ($8 000 COP) | Bajo ($5 000 COP)
Tamaño y Peso | 41×20×36 mm, 37,2 g | Compacto, ≈ 35 g (sin
driver)

Variable, ligero

Torque máximo | 4,1 kg · cm (6 V) | ≈ 0,3 kg · cm (5 V) | Variable según reduc-
tora
Consumo (idle) | 8 mA (6,0 V) | Mayor, | requiere
energía constante

Depende de la carga

Velocidad | 0,19 s/60◦
(6,0 V) | Lenta, limitada por
frecuencia de pasos

Alta (requiere control
PWM externo)
Control nativo Sí (lazo cerrado interno)
Sí (lazo abierto) | No

De acuerdo con la comparativa de la Tabla 5, el servomotor Futaba S3003 se consolida como la opción más adecuada. Aunque los motores paso a paso y los motores DC genéricos presentan ventajas en costo, el servomotor integra un controlador interno de posición y un potenciómetro que facilita un control nativo en lazo cerrado. A nivel de implementación computacional en el microcontrolador (ESP32-S3), esta característica es determinante: el control de un servomotor requiere únicamente enviar una señal PWM correspondiente al ángulo objetivo (por ejemplo, los valores de q(t) calculados en la cinemática inversa), mientras que un motor paso a paso exigiría programar rutinas de conteo de pasos desde un origen referenciado, y un motor DC requeriría implementar desde cero tanto la instrumentación (encoders) como un controlador PID completo. Sumado a esto, el torque de 4,1 kg · cm del Futaba S3003 sobrepasa holgadamente los requerimientos inerciales (del orden de 10⁻⁴ N · m), garantizando fiabilidad durante la ejecución de la trayectoria.

### 2.3. Simulación de control

Cada articulación se verificó de forma individual con el modelo motor 2gdl ctrl.slx. La tabla 6 resume el seguimiento de la trayectoria de P7 con carga mecánica y la figura 4 muestra la respuesta al escalón de 30◦

Tabla 6: Seguimiento de la trayectoria de P7 por articulación (Ts = 10 ms, carga incluida).

Articulación | RMS P [◦
] | RMS P+FF [◦
] | Máx P+FF [◦
] | |V |max [V] | |i|max [A]
Joint1 | 0,168 | 0,094 | 0,252 | 0,515 | 0,033
Joint2 | 0,234 | 0,091 | 0,263 | 0,531 | 0,034

El escalón de 30◦ presentó un sobreimpulso de hasta 0,18 % en Joint1 y 0 % en Joint2, con tiempos de establecimiento de 111 y 110 ms y errores finales de 0,22◦ y 0,20◦
. La tensión satura solo durante el escalón (|V |max = 6 V e |i|max ≈ 0,369 A); en la trayectoria los máximos son 0,515/0,531 V y 0,033/0,034 A, por lo que el seguimiento ocurre en régimen lineal. La prealimentación redujo el error RMS entre 44 % y 61 %, porque Kf f ˙θref aporta la tensión de velocidad y el término proporcional solo corrige el error restante.
La robustez ante variaciones de J entre 0,5J y 2J mantuvo el sobreimpulso entre 0,188 % y 2,180 %, con tiempos de establecimiento de 0,109–0,136 s; la mayor sensibilidad aparece al duplicar J, pero el lazo permanece estable. El error RMS de 0,094◦ y 0,091◦ y los errores finales de 0,22◦ y 0,20◦ quedan por debajo de la cuantización de 0,5◦ del sensor, de modo que la exactitud final está limitada por la instrumentación y no por el lazo de control.

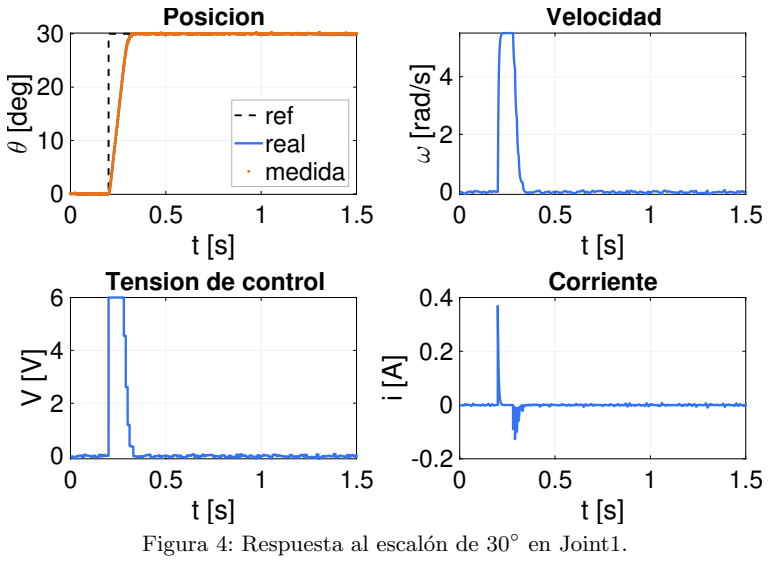
[picture p9: figure]
θ [deg]; Posicion; ref real; medida; ω [rad/s]; Velocidad; Tension de control; Corriente; Figura 4: Respuesta al escalón de 30◦; en Joint1.

## 3. Conclusiones

El modelo equivalente de primer orden reprodujo la velocidad sin carga (5,5116 rad/s), el par de bloqueo (0,4021 N·m) y la constante de tiempo (4,3 ms); la simplificación L = B = 0 y la estimación de J son aceptables para simulación, aunque no capturan la dinámica interna del servo.

Los sensores de posición y corriente son adecuados para realimentación (0,28◦ y 0,0168 A RMS); la velocidad derivada requiere filtrado (0,754 rad/s RMS) y la carga mecánica tiene un efecto despreciable (0,0013 rad/s).

El control P + prealimentación redujo el error RMS de seguimiento a 0,094◦ y 0,091◦
, con sobreimpulso
de hasta 0,18 % y estabilidad para J entre 0,5 y 2 veces el valor estimado; el desfase de montaje [60◦

, 95◦
]
evitó la saturación del sensor.

El dimensionamiento conjunto de P8 y P9 mostró que los pares requeridos son del orden de 10⁻⁴ N·m, muy inferiores al par de bloqueo del S3003 (0,4021 N·m); por tanto, la selección del actuador quedó dominada por la integración del controlador, el costo y la facilidad de interfaz, y no por el torque.

La cadena de simulación conservó la coherencia entre trayectoria, carga y control, pero también evidenció que la exactitud está limitada por la cuantización de 0,5

- del sensor y por el modelo equivalente del servo; antes de extrapolar los resultados al prototipo es necesario caracterizar experimentalmente el S3003 real y su montaje.

## Referencias

[1] Futaba, S3003 Standard Servo Datasheet. Futaba Corporation, 2019.
[2] OKYSTAR, MOTOR A PASOS 28BYJ-48. OKYSTAR, s.f.
