juandrodriguezf/robot-dibujante-2gdl/docs/informe-1/main.pdf

# Proyecto — Parte 1: Especificaciones y modelado cinemático de robot de 2 GdL

Estudiantes:

1. José Elkin Estrada Morales - estradam_jose@javeriana.edu.co
2. Juan David Rodríguez Franco - juandrodriguezf@javeriana.edu.co
3. David Santiago Mojica Lugo - david-mojical@javeriana.edu.co

## 1. Métodos y Desarrollos

### 1.1. Introducción y objetivo del proyecto

El presente proyecto tiene como objetivo diseñar y fabricar un robot manipulador de 2 grados de libertad (GdL) junto a la electrónica necesaria y la implementación de un sistema de control de movimiento. El propósito del robot será trazar una figura de manera autónoma sobre una superficie (como papel; véase la figura 1a como referencia). La forma seleccionada por el equipo de trabajo será un triángulo con vértices redondeados (como se muestra en la figura 1b), conocido matemática y formalmente como “triángulo de Reuleaux”.

(a) Drawing manipulator | de
Quanser [1]. | (b) Triaángulo de Reuleaux
Figura 1: Izquierda: Tipo de robot a diseñar. Derecha: Figura geométrica a realizar.

La tarea concreta del robot será seguir una trayectoria continua con la geometría del triángulo. Para cumplir con dicho objetivo, el sistema debe, de forma iterativa y por cada punto de la trayectoria mencionada, establecer un modelo de cinemática directa de la posición actual y, justo después, resolver la cinemática inversa de la siguiente [2], convirtiendo sus coordenadas en el espacio cartesiano en los valores requeridos de las variables articulares para que el efector final alcance dicho punto. La figura 2 muestra un diagrama de bloques que ilustra

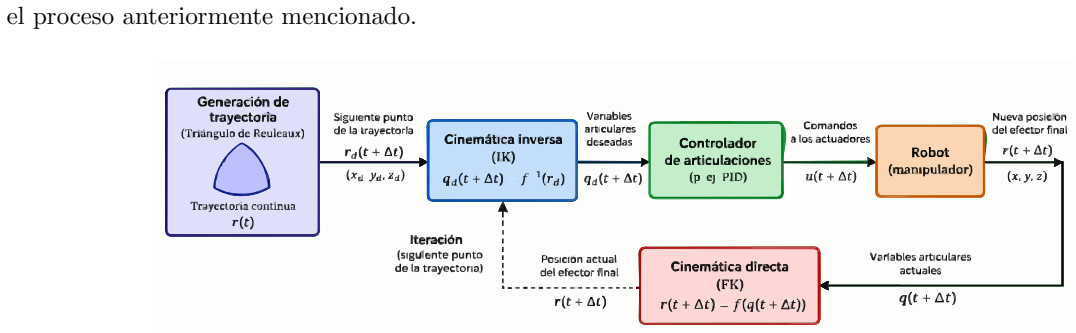
[picture p10: figure]
el proceso anteriormente mencionado.

Figura 2: Diagrama de bloques del funcionamiento del sistema

### 1.2. Requerimientos

Los requerimientos del robot dependen de aspectos como complejidad de las trayectorias, carga a soportar (en este caso un marcador), el volumen de trabajo y la dexteridad requerida. A continuación se presentan definiciones y más detalles sobre estos aspectos:

Complejidad de la trayectoria: La complejidad de una trayectoria puede cuantificarse a través de las siguientes métricas [3]:

Continuidad matemática (C

k
): En robótica, la continuidad matemática puede entenderse como la propiedad de que los movimientos de un robot no presenten cambios bruscos durante su ejecución [3]. Por ejemplo, una trayectoria puede clasificarse como C

0
si es continua (por ejemplo, que no sea necesario levantar el lápiz del papel para dibujar una figura), como C

1
es continua y así sucesivamente.

Geometría del perfil y su curvatura: La curvatura κ es una medida de qué tan “cerrado” o pronunciado es un cambio de dirección en un punto específico de la trayectoria [3]. Matemáticamente, puede definirse como κ = |xẏ¨ − yẋ¨|/( ẋ

2 + ẏ)

3/2
, donde x(t) y y(t) son las coordenadas del marcador en el plano de dibujo a través del tiempo [3].

Frecuencia de muestreo y resolución de puntos: Al seguir una trayectoria, el microcontrolador une cada uno de los puntos moviendo en línea recta el efector final. Si la frecuencia de muestreo es baja o no hay suficientes puntos en la trayectoria, las curvas no estarán bien logradas y la forma final será diferente a la esperada.

Carga a soportar: Los marcadores suelen tener una masa aproximadamente de 30 g, lo que implica un peso de 0.294 N. No es una carga significativa.
Volumen de trabajo: Es el conjunto de todos los puntos en el espacio tridimensional o bidimensional (x, y) que el efector final del robot puede alcanzar [3]. Para un robot de 2 GdL plano, el volumen de trabajo es una región plana 2D con la forma de una semicorona circular con radio interior Rmin = L1 − L2 y radio exterior Rmax = L1 + L2. Como se verá en la sección 2, se seleccionó L1 = 20 cm y L2 = 10 cm. En ese orden de ideas, la región plana 2D del volumen de trabajo corresponde a una semicorona circular, mientras que la región 3D por la que el efector final puede desplazarse se muestra en la figura 3.

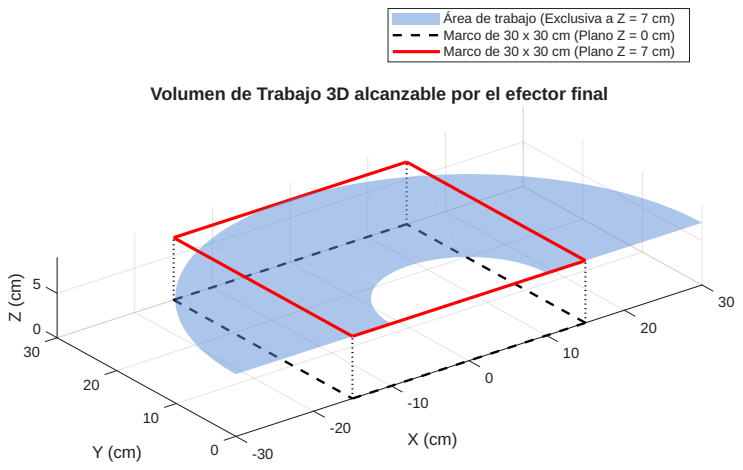
[picture p11: figure]
Área de trabajo (Exclusiva a Z = 7 cm) Marco de 30 x 30 cm (Plano Z = 0 cm) Marco de 30 x 30 cm (Plano Z = 7 cm)

Volumen de Trabajo 3D alcanzable por el efector final

Figura 3: Volumen de trabajo 3D del robot manipulador

Dexteridad: Es la capacidad cinemática del manipulador para cambiar libremente la posición y orientación de de su efector final en un punto específico del espacio de trabajo [3]. Se cuantifica matemáticamente a partir de la matriz jacobiana J(q) y métricas como el Índice de Manipulabilidad de Yoshikawa, definido como w(q) = p
det(J(q)J

T (q)) [3]. Para robots planares de 2 GdL, w(q) puede escribirse como w(q) = |L1L2 sin(θ2)| [3], donde θ2 es el ángulo asociado a la segunda articulación. w(q) mide qué tan “lejos” está el robot de una configuración singular.
Por otra parte, otra métrica es el Número de Condición del Jacobiano [3], expresado como

κ(J) = ∥J∥ · ∥J

−1
∥ =

σmax

σmin

,

donde σmax y σmin son, respectivamente, los valores singulares máximos y mínimos de J.
Teniendo en cuenta todos los aspectos mencionados anteriormente, los requerimientos establecidos para el sistema se muestran en la tabla 1.

Cuadro 1: Requerimientos del sistema
Especificación | Métrica | Breve justificación
Continuidad matemática | C 1 (posición y velocidad con-tinuas) | Garantiza transiciones suaves de movi-miento
Velocidad cartesiana en los vértices | v → 0 (tendiendo a cero) | Prevenir discontinuides en la función de curvatura κ.
Tiempo de muestreo | ∆t ≤ 0,01 s (fs ≥ 100 Hz) | Garantizar un seguimiento fino y evitar la poligonalización del trazado curvo.
Orden polinómico de interpo-lación | Polinomios de orden 3 (spli-nes cúbicos) | 1 Asegura la continuidad C , proporcio-nando perfiles de velocidad continuos.
Capacidad de carga útil (Pay-load) | ≥ 0,294 N (30 g) | Garantizar el soporte del marcador sin afectar la dinámica.
Alcance radial de la zona de trabajo | Semicorona circular con Rmin = 10 cm y Rmax = 30 cm | Contener al triángulo de Reuleaux, alejándolo de los límites físicos y con-figuraciones singulares del brazo.
Límite del Índice de Yoshika-wa | Evitar θ2 = 0◦ y θ2 = 180◦ | Evitar la pérdida de grados de libertad por efecto de singularidades.
Número de Condición del Ja-cobiano | κ(J) cercano a 1 (κ(J) ≪ ∞) | Evitar configuraciones singulares (de forma parecida al índice de Yoshikawa)

### 1.3. Componentes

Los componentes necesarios para el robot se muestran en la tabla 2.

Cuadro 2: Componentes del sistema con características, función y costos asociados
Componente | Características | Función | Costo (COP)
Servomotores Futa-ba S3003 (x2) | Torque: 4.1 kg-cm Voltaje: 6 V Rotación: 180◦ Velocidad*: 0.19 s / 60◦ | Actuadores | $37 800
Microcontrolador ESP32-S3 | Procesador Xtensa® LX7 de doble núcleo 16 MB de memoria Flash 8 MB de memoria PSRAM | Solución de problemas ci-nemáticos, control de movi-miento e interpolación de tra-yectorias. | Posesión del equipo
Lámina de balso | Tamaño | Material para base y eslabo-nes. | $20 000
Marcador Sharpie | Color negro | Dibujo | $2 500

∗ Como puede intuirse, las velocidades máximas articulares del robot coinciden con las velocidad de los servomotores.

## 2. Diseño y parámetros DH

El robot tiene una base fija y dos eslabones de balso, cada uno movido por un servo; el esfero va en el extremo del eslabón 2. Los dos ejes son verticales y paralelos, por lo que la punta se mueve en el plano del papel. Marcos y parámetros DH. Se usó la convención DH estándar (Fig. 4). El marco mundo {W} está sobre el papel y {0} queda sobre el eje del servo 1 a h0 = 48,5 mm de altura: W T0 = trasl(0, 0, h0). Los ejes z0 y z1 son verticales, así que α1 = α2 = 0 y las articulaciones son rotacionales (σi = 0). Los demás parámetros salen de la geometría (Tabla 3): a1 = 200 mm y a2 = 100 mm son las distancias entre ejes; d1 = 20 mm es la altura de {0} a {1} (plano del eslabón 2), por lo que {1} queda a h0 + d1 = 68,5 mm del papel; y d2 = −68,5 mm baja de {1} hasta {2}, ubicado en la punta del esfero sobre el papel (zW = 0).
Con estos valores, las matrices de transformación son

0A1 =

c1 | −s1 | 0 0,2c1
s1 | c1 | 0 0,2s1
0 | 0 | 1 | 0,02
0 | 0 | 0 | 1

,

1A2 =

c2 | −s2 | 0 | 0,1c2
s2 | c2 | 0 | 0,1s2
0 | 0 | 1 −0,0685
0 | 0 | 0 | 1

(1)

Cuadro 3: Parámetros DH (estándar), qi ∈ [−90◦

, 90◦
]
i | θi | di
| | [m] | ai
[m] | αi
| | | | [rad] | σi
1 | q1 | +0,0200 | 0,2000 | 0 | 0
2 | q2 | −0,0685 | 0,1000 | 0 | 0

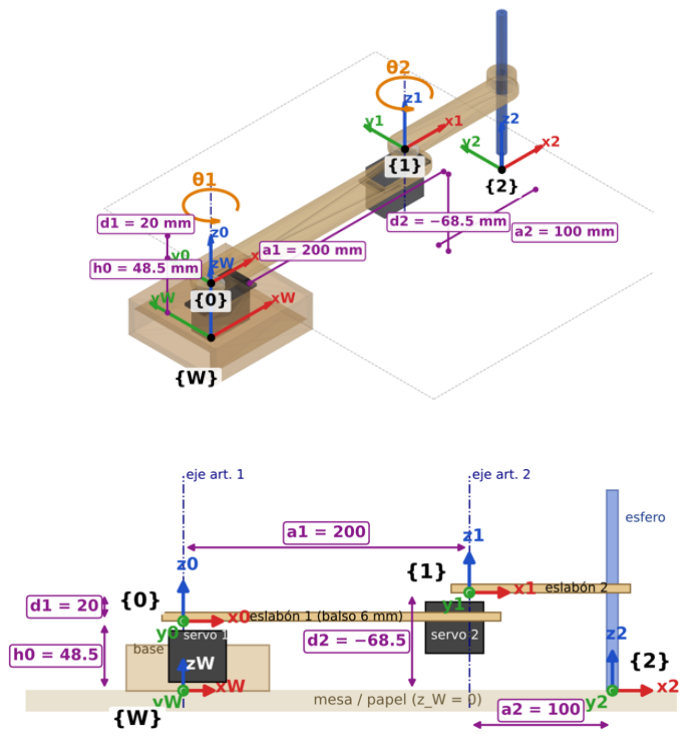
[picture p12: figure]

Figura 4: Marcos {W}, {0}, {1}, {2} y dimensiones del robot.

y W T2 = W T0

0A1

1A2. La altura de la punta es 0,0485 + 0,02 − 0,0685 = 0 y su posición en el plano es x = 0,2 cos q1 + 0,1 cos(q1 + q2), y = 0,2 sin q1 + 0,1 sin(q1 + q2). En home la punta queda en (0,3; 0; 0) m. Masas e inercias. Se obtuvieron en SolidWorks (propiedades de masa) agrupando las piezas por cuerpo rígido: la base lleva el servo 1 y el eslabón 1 lleva el servo 2, que viaja con él; el eslabón 2 incluye el balso, el horn y el esfero. Los valores están referidos al centro de masa y expresados en los ejes del marco {i} de cada eslabón. Las masas son m1 = 43,90 g y m2 = 10,34 g (54,24 g en movimiento), con centros de masa r1 = [−0,02689; 0; −0,02310] m y r2 = [−0,02227; 0; 0,07451] m, y tensores de inercia (kg m²
)

I1 =

6,0512e−6 | 0 | 3,7272e−6
0 | 1,0736e−4 | 0
3,7272e−6 | 0 | 1,0469e−4
- (2)

I2 =

8,5081e−6 | 0 | −1,0612e−6
0 | 2,2523e−5 | 0
−1,0612e−6 | 0 | 1,4440e−5
- (3)

Como los ejes son verticales, en el plano solo intervienen Izz y la posición de los centros de masa.
Validación. El modelo se implementó con SerialLink cargando la Tabla 3 y los valores anteriores, y se verificó que: (i) fkine([0 0]) da (0,3; 0; 0) m, igual al CAD; (ii) con 2000 poses aleatorias, fkine coincide con


Figura 5: Modelo CAD del plotter: vista isométrica (izq.) y lateral (der.).

las matrices DH a mano y con la geometría analítica (error < 10⁻¹²); (iii) la matriz de inercia M(q) de la toolbox coincide con un cálculo independiente por Steiner (error < 10⁻¹⁰); (iv) la masa en movimiento coincide con SolidWorks; y (v) gravload ≈ 0, pues la estructura soporta el peso y los servos solo vencen la inercia.

## 3. Modelo CAD

El modelo se realizó en SolidWorks como ensamblaje (Plotter 2GdL.SLDASM) con base, dos eslabones de balso de 6 mm, dos servos S3003, horn y esfero (Fig. 5). De él se extrajeron las longitudes, los desplazamientos di

, las masas y las inercias usadas arriba.

## 4. Resultados

### 4.1. Cinemática directa

La cinemática directa se implementó en forward kinematics(DH,q) sobre los marcos de la figura 4 y se validó en q = [60◦

, −50◦
]: coincide con la solución analítica y con SerialLink.fkine del Robotics Toolbox con un error máximo de 2,8 × 10⁻¹⁷ m. El volumen de trabajo es una corona con Rmin = L1 − L2 = 0,1 m y Rmax = L1 + L2 = 0,3 m que contiene al triángulo de Reuleaux.

### 4.2. Cinemática inversa

Para el brazo plano p˙ e = Jv(q) q˙ , con Jv el Jacobiano lineal y det Jv = L1L2 sin q2 (singular en q2 = 0◦ o 180◦
). La inversa itera qk+1 = qk + J

+
v
pobj − pe(qk)
(pseudoinversa de Moore–Penrose, amortiguada cerca de singularidades). El Jacobiano se verificó en q = [30◦

, −70◦
], donde det Jv = −0,018794 = L1L2 sin q2. Para pobj = [0,08; 0,20] m la forma cerrada da las ramas A q = [40,7

◦
, 95,2

◦
] y B q = [95,7

◦
, −95,2

◦
]; ikine recupera ambas
según la semilla con error de posición < 3 × 10⁻¹¹ m (figura 6a). El índice de manipulabilidad w = L1L2|sin q2| es máximo en r =

p
L

2
1 + L

2
2 = 0,2236 m y tiende a cero en los límites r = 0,1 y 0,3 m (figura 6b).

### 4.3. Planeación de trayectorias

Se trazó el triángulo de Reuleaux (w = 0,10 m, centro (0; 0,20) m), discretizado en 50 puntos e interpolado con splines cúbicos; un reescalado temporal suave anula la velocidad cartesiana en los tres vértices. Con muestreo ∆t = 0,01 s (2001 puntos) la inversa convergió en todos los puntos con error < 1 × 10⁻¹⁰ m. Las figuras 7a y 7b muestran las trayectorias cartesiana y articular; las velocidades máximas (0,15 y 0,21 rad/s) quedan por debajo del límite de los servos S3003 (5,5 rad/s). La figura 8 presenta la simulación con el modelo CAD real.

## 5. Conclusiones

El modelo cinemático quedó validado: la cinemática directa coincide con la analítica y con el Robotics Toolbox (error ∼ 10⁻¹⁷ m), y la inversa por el Jacobiano recupera ambas configuraciones con error < 10⁻¹⁰ m, lejos de las singularidades (q2 = 0◦

, 180◦
).
La planeación genera perfiles articulares C

1
con velocidad nula en los vértices y convergencia en los 2001 puntos; las velocidades máximas (0,15 y 0,21 rad/s) quedan bajo el límite del servo (5,5 rad/s).

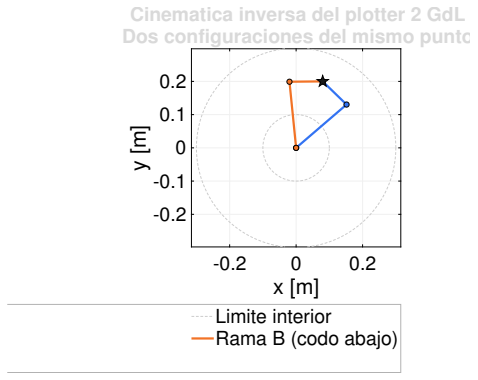
[picture p13: figure]
Cinematica inversa del plotter 2 GdL Dos configuraciones del mismo punto; Limite interior Rama B (codo abajo)

(a) Ramas A y B (codo arriba/abajo) al mismo punto.

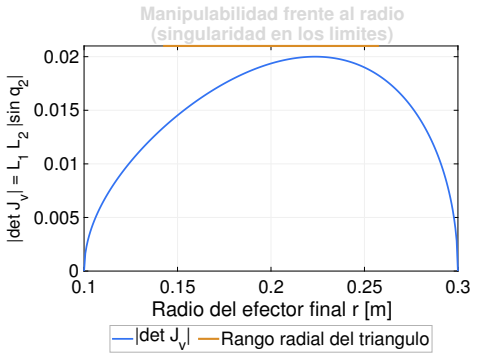
[picture p14: figure]
Radio del efector final r [m]; |det J; 2 |sin q; Manipulabilidad frente al radio (singularidad en los limites); |det J v; Rango radial del triangulo

(b) Manipulabilidad | det Jv| vs. radio r.
Figura 6: Resultados de la cinemática inversa.

t [s]

0 | 10 | 20

posicion [m]

-0.1

0

0.1

0.2

0.3 Posicion cartesiana

x(t)
y(t)

x [m]

-0.2 | 0 | 0.2

y [m]

-0.3

-0.2

-0.1

0

0.1

0.2

0.3

Trayectoria en el plano

Limite exterior | Limite interior
Via points | Interpolada
Inicio
(a) Trayectoria cartesiana x(t), y(t) y trazado.

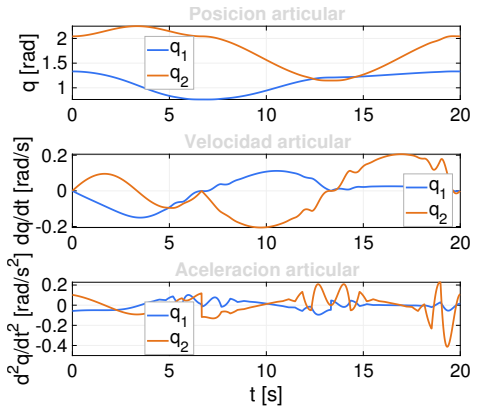
[picture p15: figure]
q [rad] 1 1.5; Posicion articular; dq/dt [rad/s]; Velocidad articular; 2 [rad/s; Aceleracion articular

(b) Trayectorias articulares q(t), ˙q(t), ¨q(t). Figura 7: Resultados de la planeación de trayectorias.

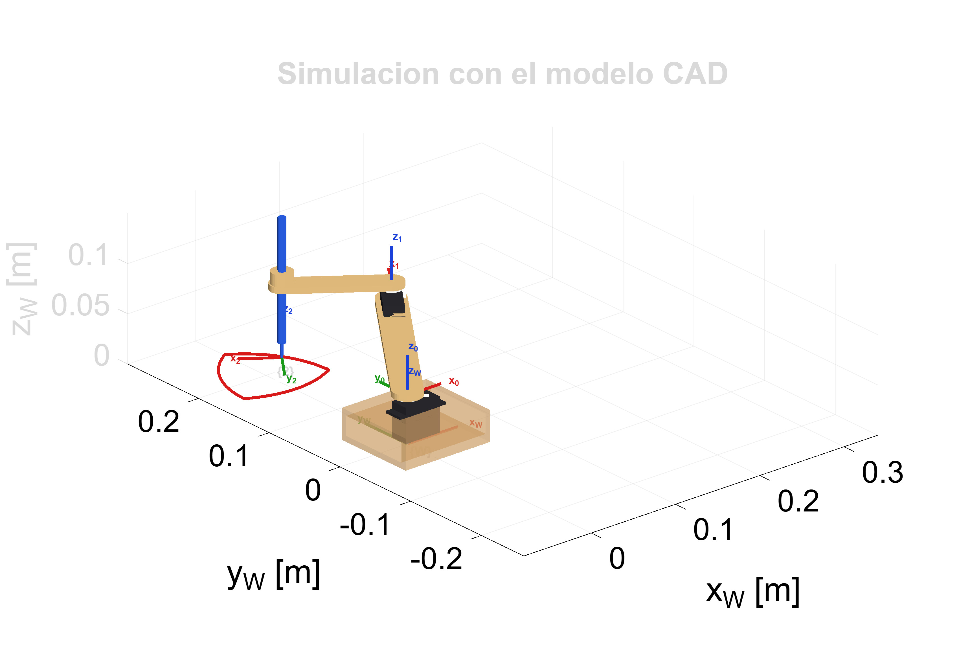
[picture p16: figure]

Figura 8: Simulación con el modelo CAD real ejecutando el trazado.

## Referencias

[1] A. S. Barbosa et al., “Design and development of a manipulator for educational robotics,” 2018 Latin American Robotic Symposium, 2018.
[2] Y. Nakamura and H. Hanafusa, “Inverse kinematic solutions with singularity robustness,” ASME Journal of Applied Mechanics, vol. 53, pp. 187–193, 1986.
[3] M. W. Spong, S. Hutchinson, and M. Vidyasagar, Robot Modeling and Control. Wiley, 2006.
