juandrodriguezf/robot-dibujante-2gdl/docs/media/sim_cuadro_1.png

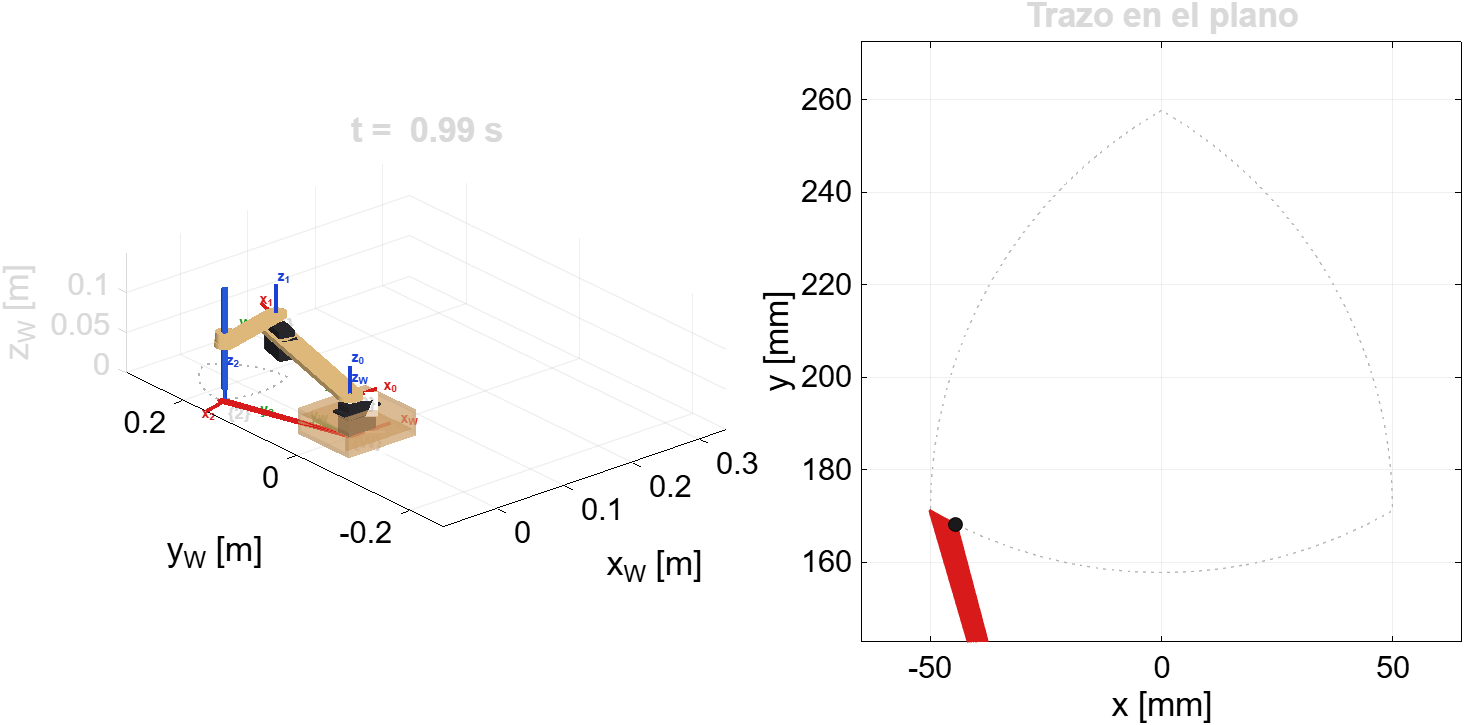
docs/media/sim_cuadro_1.png
