juandrodriguezf/robot-dibujante-2gdl/docs/media/sim_cuadro_2.png

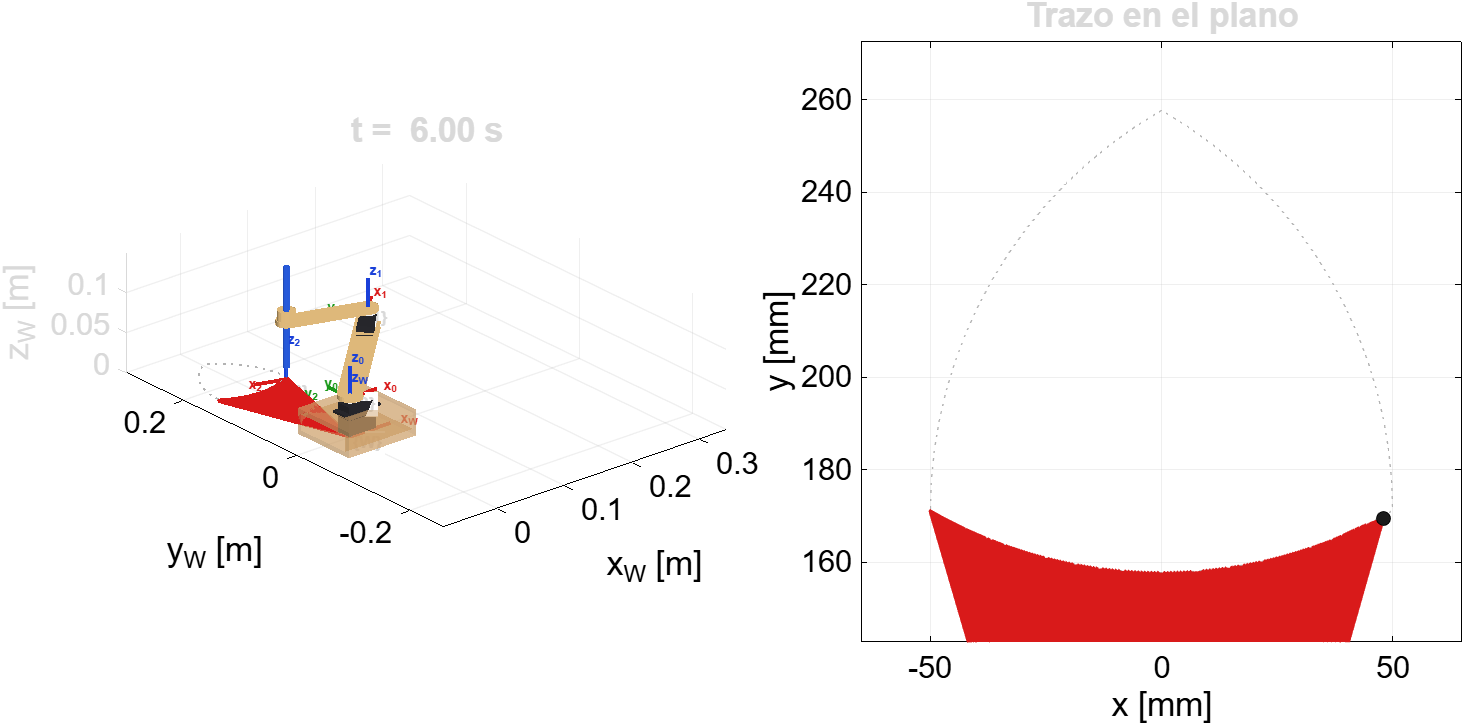
docs/media/sim_cuadro_2.png
