juandrodriguezf/robot-dibujante-2gdl/docs/media/sim_cuadro_3.png

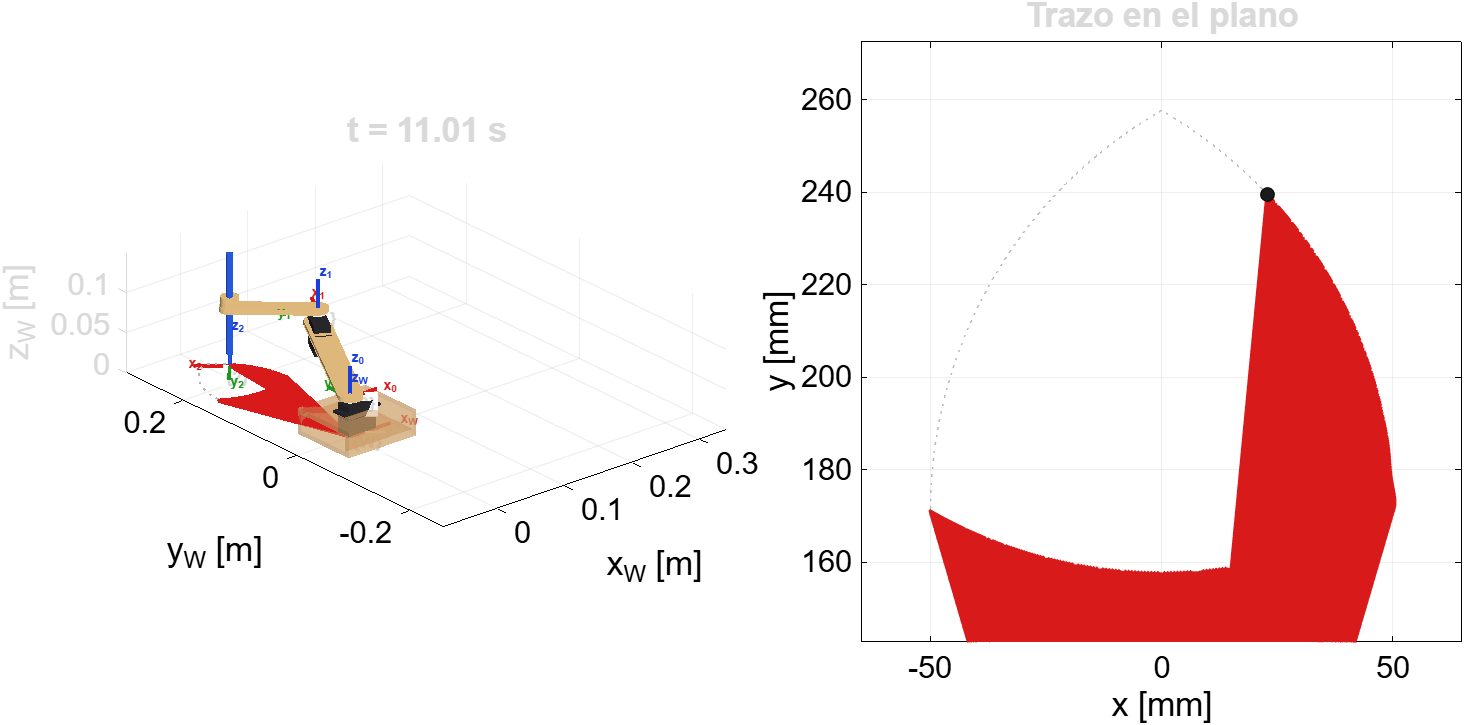
docs/media/sim_cuadro_3.png
