juandrodriguezf/robot-dibujante-2gdl/docs/media/sim_cuadro_4.png

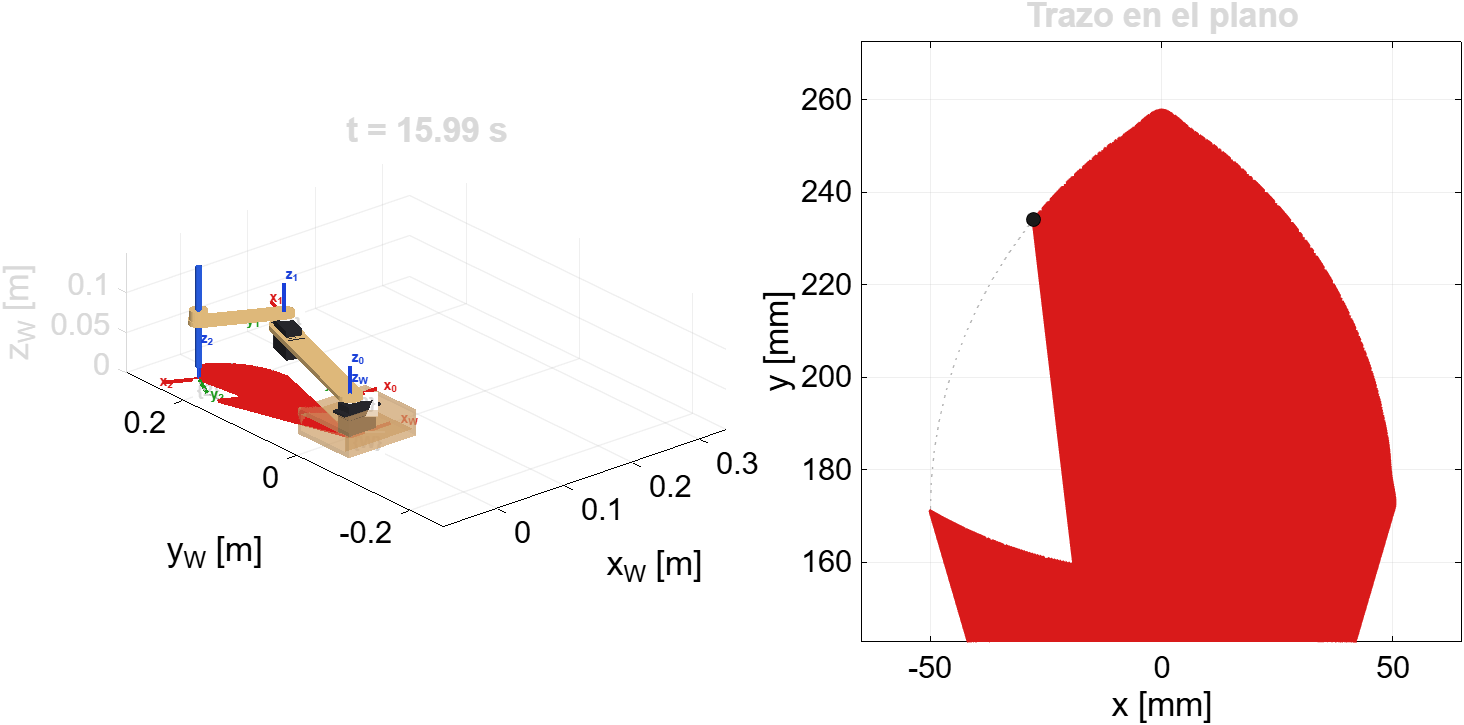
docs/media/sim_cuadro_4.png
