juandrodriguezf/robot-dibujante-2gdl/docs/media/simulacion_plotter.gif

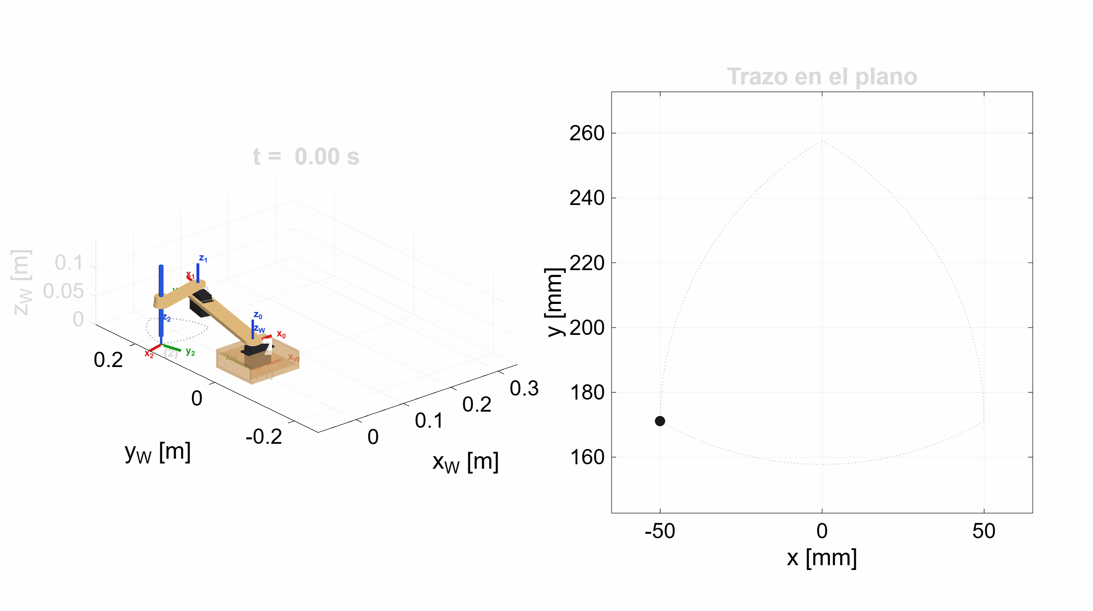
docs/media/simulacion_plotter.gif
