juandrodriguezf/robot-dibujante-2gdl/(list of files, cad)

Other CAD files:
cad/Plotter_2GdL.SLDASM
cad/Base.SLDPRT
cad/Horn.SLDPRT
cad/Servo_S3003.SLDPRT
cad/Esfero.SLDPRT
cad/Eslabon1.SLDPRT
cad/Eslabon2.SLDPRT
cad/export/Base.STL
cad/export/Esfero.STL
cad/export/Eslabon1.STL
cad/export/Eslabon2.STL
cad/export/Horn.STL
cad/export/Servo_S3003.STL
