juandrodriguezf/robot-dibujante-2gdl/docs/informe-2/figuras/motor_diagrama_sim.pdf

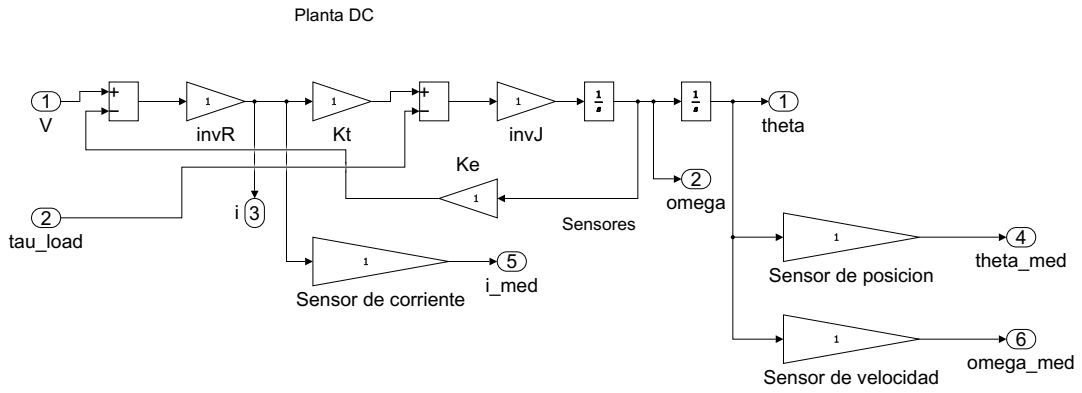
[picture p22: page 1]
Sensores; Planta DC; 2 tau_load; invR; invJ; 1 theta; 2 omega; 4 theta_med; 5 i_med; 6 omega_med

Sensor de posicion

Sensor de corriente

Sensor de velocidad
