juandrodriguezf/robot-dibujante-2gdl/docs/informe-1/figuras/diagrama_bloques.pdf

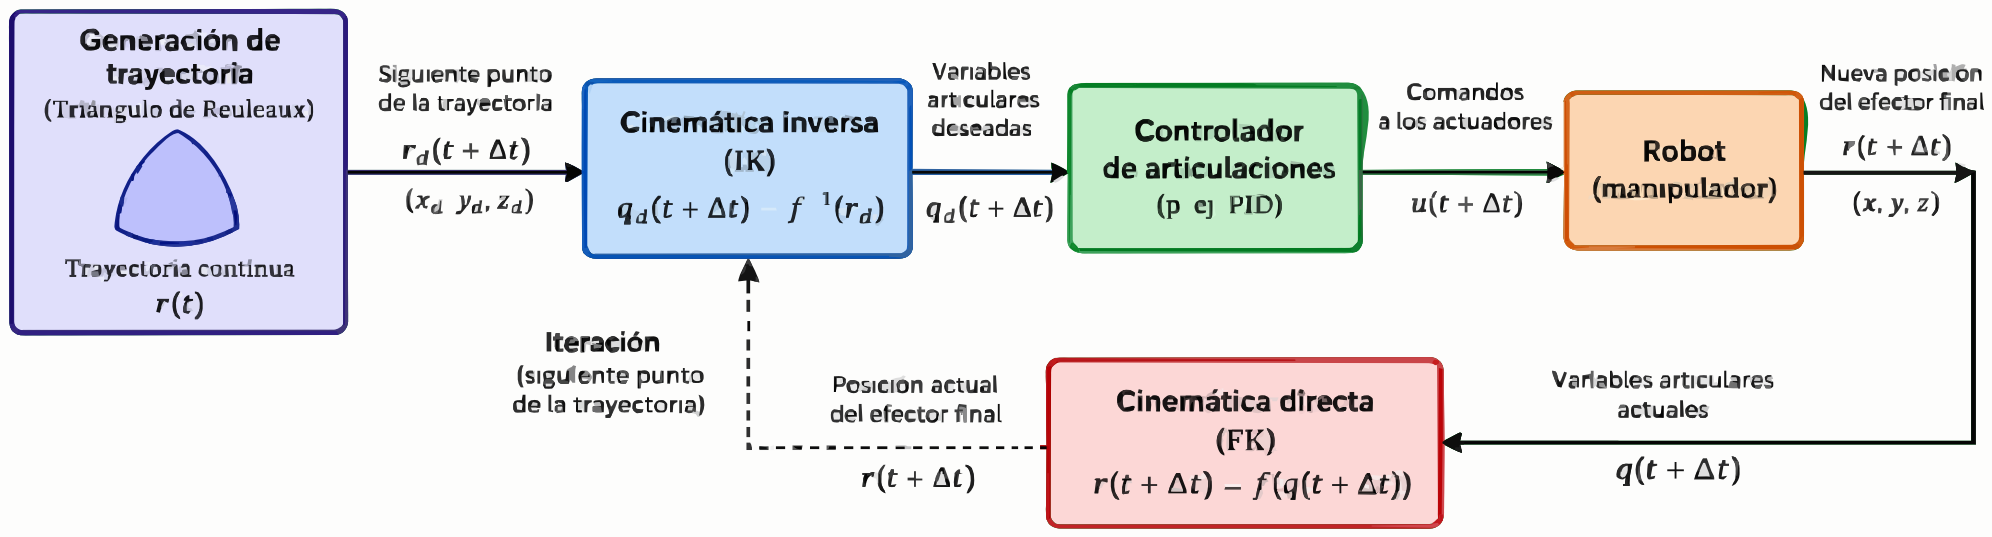
[picture p23: page 1]
