juandrodriguezf/robot-dibujante-2gdl/docs/informe-1/figuras/quanser.pdf

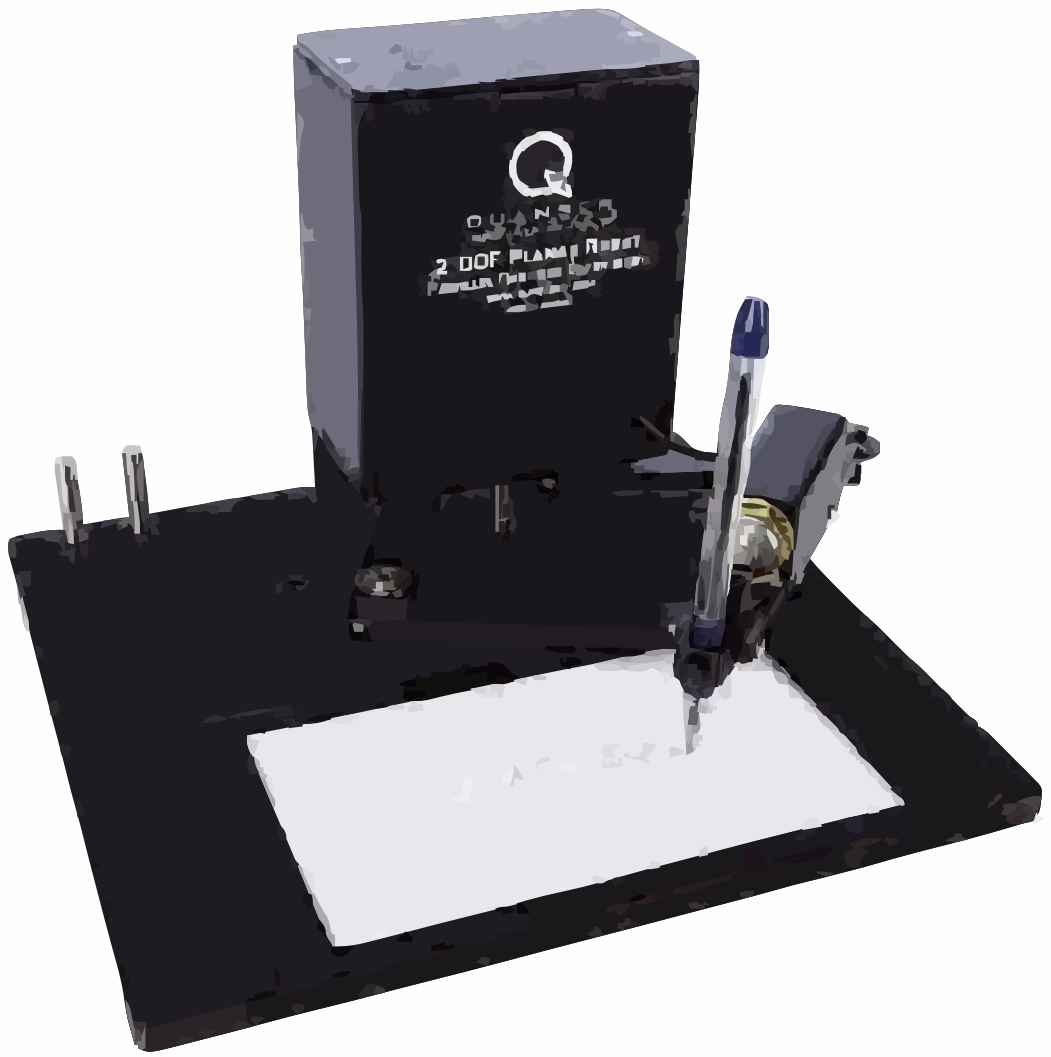
[picture p24: page 1]
