juandrodriguezf/robot-dibujante-2gdl/docs/informe-1/figuras/triangulo_reuleaux.pdf

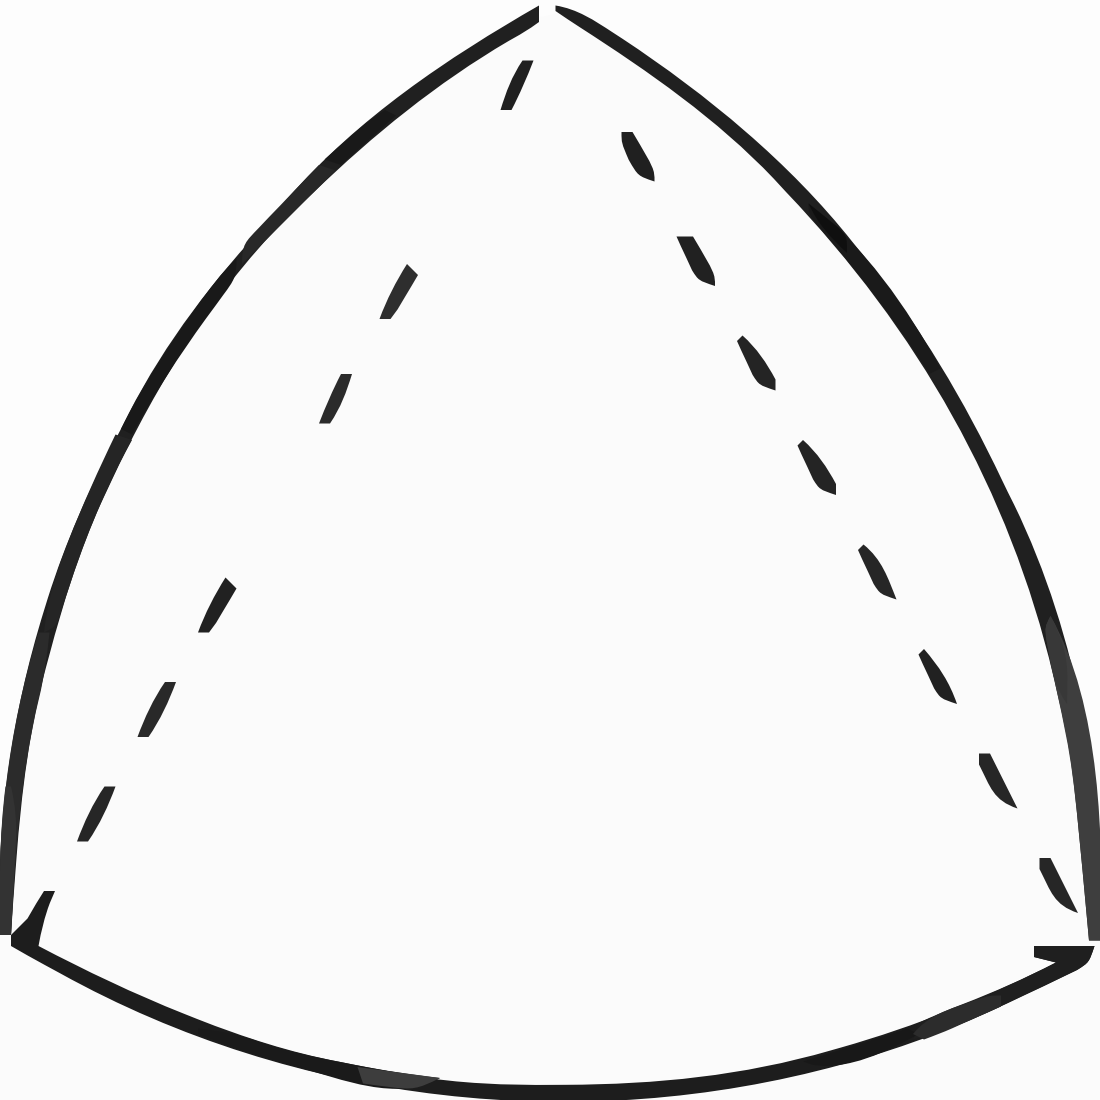
[picture p25: page 1]
