juandrodriguezf/robot-dibujante-2gdl/(commit log)

2026-10-12 Estructura inicial: repo, README, licencia, CAD (LFS) e informe 1
    [Base.SLDPRT, Esfero.SLDPRT, Eslabon1.SLDPRT, Eslabon2.SLDPRT, Horn.SLDPRT, Plotter_2GdL.SLDASM, Servo_S3003.SLDPRT]
2026-10-12 cinemática inversa por Jacobiano (dos ramas y análisis de singularidad)
2026-10-12 Trayectorias del robot dibujante: contorno de Reuleaux, splines e inversa por Jacobiano
2026-10-12 Integra el modelo CAD del companero: DH con cadena vertical, masas reales y simulacion con mallas
    Incorpora el modelo del companero (mismo robot): tabla DH completa con cotas verticales d1=0.020, d2=-0.0685 y marco base {W}->{0}=trasl(0,0,0.0485) (efector en z=0 sobre el papel); masas, CDM e inercias reales del CAD en plotter_param; soporte de marco base en forward_kinematics, homogenous_matrix, Jacobian e ikine; exportacion de propiedades y mallas STL del CAD; y simulacion del trazado con el modelo CAD real (plotter_cad). Ajusta tambien el estilo de figuras a las NOTAS (lienzo cuadrado, titulos completos y fuente >= 24 pt).
    [Base.STL, Esfero.STL, Eslabon1.STL, Eslabon2.STL, Horn.STL, Servo_S3003.STL]
2026-10-12 Simulacion animada con mallas CAD: video y GIF del trazado de Reuleaux
    - Agrega simulacion_plotter.m (animacion con plotter_cad) y la integra en main.m
    - Exporta simulacion_plotter.mp4/.gif y sim_cuadro_1-4.png a docs/media/
2026-10-12 Reemplaza el informe de la Entrega 1 por la version final de 6 paginas
    - Integra el documento del equipo (Parte 1) con los Puntos 5-7 y las conclusiones
    - Reorganiza las figuras en docs/informe-1/figuras/ con nombres descriptivos
    - Elimina imagenes y auxiliares sin uso
2026-10-12 Agrega el PDF compilado del informe 1 al repositorio
    - Quita docs/*/main.pdf del .gitignore para versionar el PDF de cada entregable
2026-10-12 Ordena el repositorio: nombres, ubicacion de parametros y README
    - Renombra homogenous_matrix.m -> homogeneous_matrix.m y Jacobian.m ->
    geometric_jacobian.m, actualizando llamadas, comentarios e ids de error
    - Mueve plotter_param.m a matlab/params/ y agrega esa ruta en los scripts
    - Alinea las figuras exportadas con el informe (ik_ramas, ik_singularidad)
    - Actualiza el README: estructura, como reproducir y estado del Informe 1
2026-10-12 Marca los binarios como -text para evitar diffs espurios
    - .gitattributes: pdf, eps, png, jpg, gif, mp4 y mat como binarios
    - Renormaliza el PDF del informe y las figuras .eps tras el cambio
2026-11-12 Integra la dinamica inversa Newton-Euler del companero (P8)
    Integra el codigo de P8 del companero. La recursion 6D original no coincidia con el Robotics Toolbox (inercia ~14x menor y sin Coriolis), asi que se reemplaza por la formulacion 3D validada, manteniendo la interfaz ID(DH, PARAM, q, qd, qdd, grav, F_ext). No se incluye skew.m: no lo usa la formulacion corregida y sombrearia la funcion skew del Robotics Toolbox.
2026-11-12 Agrega el resumen de torques por articulacion (P8)
    Agrega el script de resumen de torques del companero. Corrige el wrench externo a [0 0 -0.294 0 0 0] (fuerza normal al papel, no momento) y usa el tensor de inercia completo cuando esta disponible. Incluye guardas de variables y rutas para ejecutarlo despues de trayectoria_test.
2026-11-12 Valida la dinamica inversa contra Robotics Toolbox (P8)
    Compara ID con SerialLink.rne en 200 poses aleatorias, con el tensor completo y con la parte diagonal de PARAM, y verifica el par debido a una fuerza externa en el plano contra Jv'*f.
2026-11-12 Reporta los torques en mN.m y justifica su magnitud (P8)
    Los pares son del orden de mN.m porque las articulaciones giran sobre ejes verticales: la gravedad y la fuerza normal del lapiz no producen par; solo quedan inercia y Coriolis de eslabones muy livianos. Con la trayectoria de Reuleaux: q1 <= 0.177 mN.m y q2 <= 0.032 mN.m.
2026-11-12 Agrega main2 y documenta la ejecucion de P7-P8
    main2.m ejecuta trayectoria_test como insumo y luego dinamica_inversa. El README explica como correr la Parte 2 y marca el informe 2 en progreso.
2026-11-12 Agrega los parametros del motor y los sensores (P10)
2026-11-12 Construye el modelo de motor DC de primer orden (P10)
2026-11-12 Conecta la carga mecanica de P8 al modelo (P10)
2026-11-12 Verifica el modelo y agrega las figuras (P10)
2026-11-12 Documenta P10 con la plantilla del informe
2026-11-13 Integra P11 con control de bajo nivel
2026-11-13 Ajusta P11 al limite de seis paginas
2026-11-13 Finaliza el informe 2 y limpia archivos auxiliares
